Eggmansmile/DIY-Auto/Drawings/DIY-Auto_v4.pdf

## BOVENAANZICHT

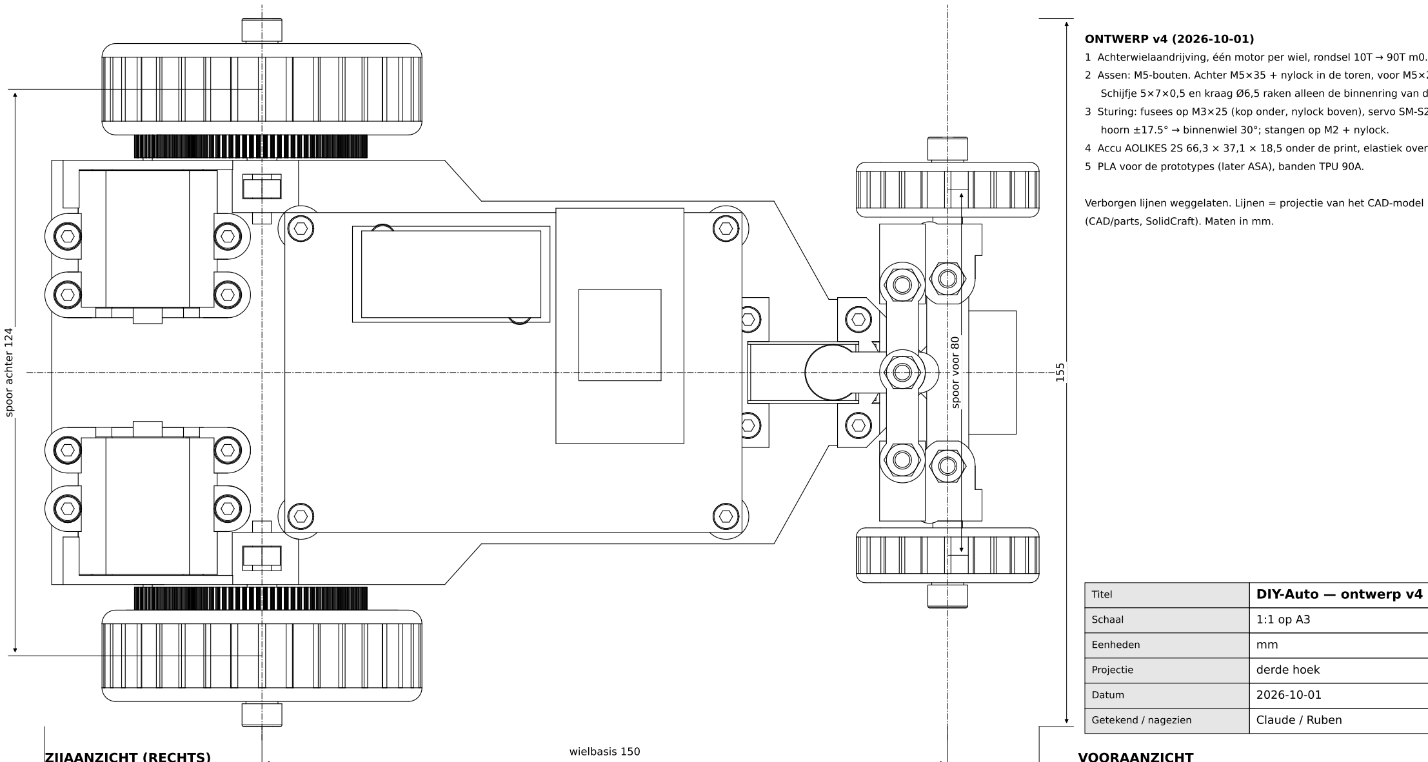
[picture p6: figure]
ONTWERP v4 (2026-10-01); (CAD/parts, SolidCraft). Maten in mm.; Titel; DIY-Auto — ontwerp v4; Schaal; Eenheden; Projectie; derde hoek; Datum; Getekend / nagezien; Claude / Ruben; wielbasis 150; spoor voor 80; spoor achter 124

ZIJAANZICHT (RECHTS) | VOORAANZICHT

1 Achterwielaandrijving, één motor per wiel, rondsel 10T → 90T m0.5 in de velg (9:1).

2 Assen: M5-bouten. Achter M5×35 + nylock in de toren, voor M5×20 + moer in de fusee.

Schijfje 5×7×0,5 en kraag Ø6,5 raken alleen de binnenring van de MR105.

3 Sturing: fusees op M3×25 (kop onder, nylock boven), servo SM-S2309S rechtop,
hoorn ±17.5° → binnenwiel 30°; stangen op M2 + nylock.

4 Accu AOLIKES 2S 66,3 × 37,1 × 18,5 onder de print, elastiek over 4 haakjes.

5 PLA voor de prototypes (later ASA), banden TPU 90A.

Verborgen lijnen weggelaten. Lijnen = projectie van het CAD-model

218

Ø70

Ø40

70

10

155
