Eggmansmile/DIY-Auto/Auto Design.excalidraw.md

---

excalidraw-plugin: parsed
tags: [excalidraw]

---
==⚠  Switch to EXCALIDRAW VIEW in the MORE OPTIONS menu of this document. ⚠== You can decompress Drawing data with the command palette: 'Decompress current Excalidraw file'. For more info check in plugin settings under 'Saving'

# Excalidraw Data

## Text Elements
differentieel aandrijving
met links of rechts die meer power krijgt
 ^oEhwQtGx

esp ^Jzh4QipB

esp ^W9gn68HW

wielen ^z8BO2pZM

holes for mounting
 ^FxBgVjIp

grote wielen vanachter
kleine wielen vanvoor zonder aandrijving ^ARltkxSG

rond binnenwiel ^oJuK1OJ4

car body ^HocfC2jY

treaded insert m2 ^xUrt5vSw

clamps like that so motor stays tight and cant go anywhere
while it just slots into the body and then gets clamped when
assembled with car body ^4d9SldyF

front wheels ^lo8yKOJZ

Concept v2 — Claude, 2026-09-26
• Rear wheel drive, 1 motor per wheel, 7:1 in one stage:
   pinion 10T m0.6 → 70T (Ø42) on the inside of the wheel, centre distance 24
• Front: steered by servo GWS Mini STD, C-hub knuckles on M3 kingpins, ±30°, servo upside down, TPU tyres
• Axles fixed (Ø5 steel), wheels on 2× MR105 each → 8 of the 10 bearings
• Motor in a cradle in the body, clamp on top with 2× M2 into inserts
• Battery 3×18650 in front of the rear axle, PCB above it on M3 standoffs
• PCB gets buck converter 12 V → 5 V + servo header; powerbank goes
• Car 212 × 144 × 61 mm, wheelbase 150, rear track 124 ^clV2txt1

## Embedded Files
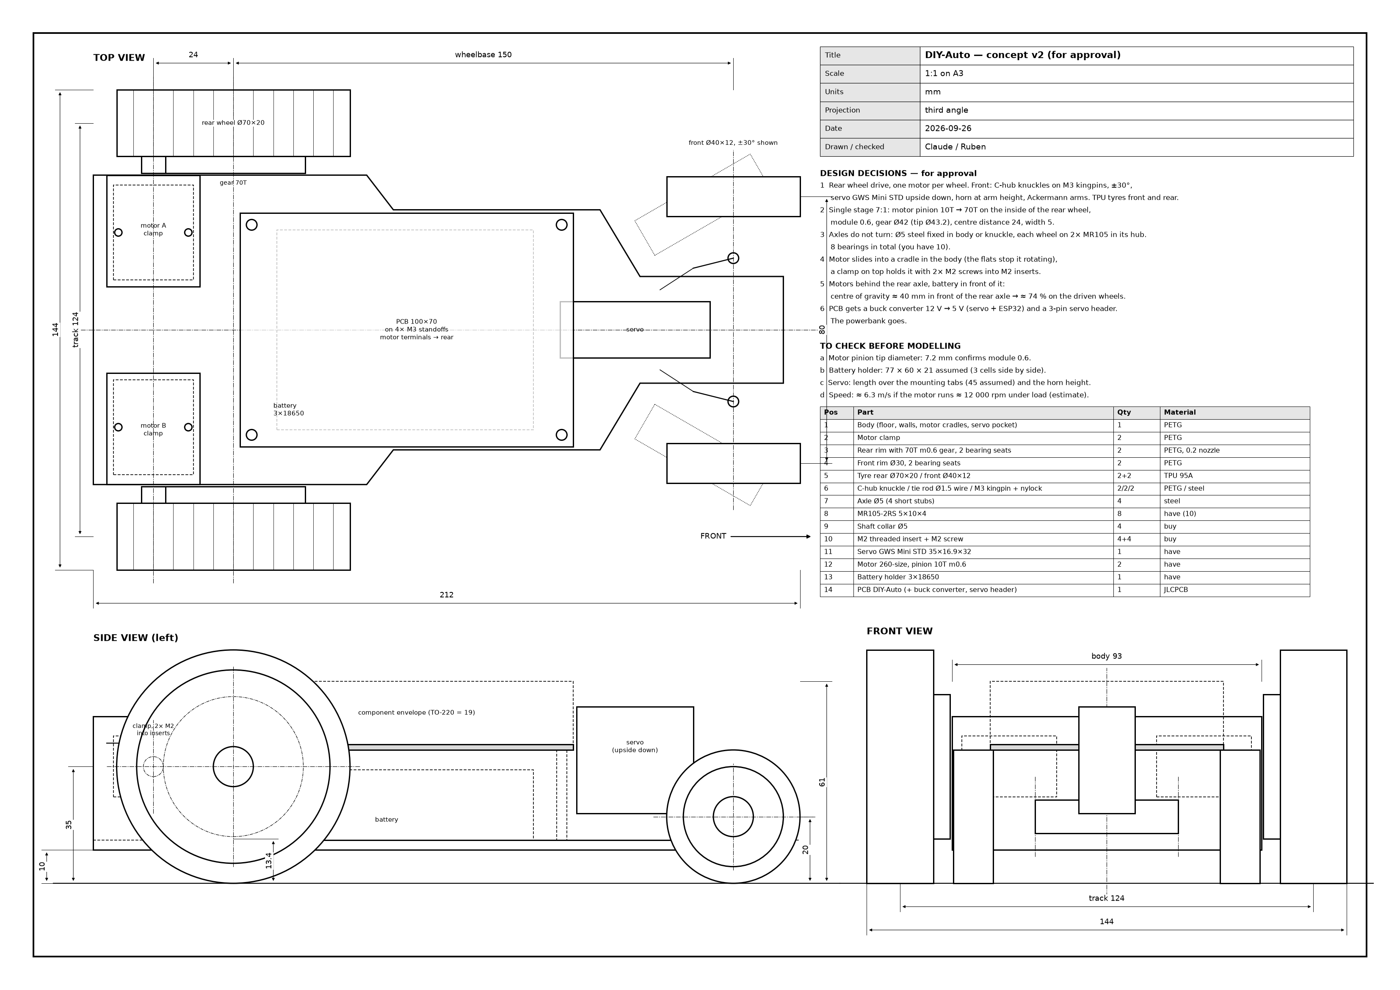
[picture p7: Drawings/DIY-Auto_concept_v2.png]
5c9b796a37b0570447a3e996b1d5a22d1349265a: 
d5ef25c8e838adc9a45d4e26cbdbbc654350cd61: 

d14e5dffaff56cf9605681765ca7cb864923935a: 

%%
## Drawing
```json
{
	"type": "excalidraw",
	"version": 2,
	"source": "https://github.com/zsviczian/obsidian-excalidraw-plugin/releases/tag/2.27.3",
	"elements": [
		{
			"id": "P3kD2CfJ9Grdw8lFDF6dV",
			"type": "freedraw",
			"x": -770.7141418457031,
			"y": -715.5225103339919,
			"width": 16.4273681640625,
			"height": 12.041351318359375,
			"angle": 0,
			"strokeColor": "#1e1e1e",
			"backgroundColor": "transparent",
			"fillStyle": "solid",
			"strokeWidth": 1,
			"strokeStyle": "solid",
			"roughness": 1,
			"opacity": 100,
			"groupIds": [],
			"frameId": null,
			"index": "a5",
			"roundness": null,
			"seed": 472087365,
			"version": 29,
			"versionNonce": 1761470539,
			"isDeleted": false,
			"boundElements": [],
			"updated": 1789668760306,
			"link": null,
			"locked": false,
			"points": [
				[
					0,
					0
				],
				[
					-1.095458984375,
					-1.091156005859375
				],
				[
					-1.095458984375,
					0
				],
				[
					0,
					0
				],
				[
					1.095458984375,
					1.095458984375
				],
				[
					2.19091796875,
					2.190887451171875
				],
				[
					4.38177490234375,
					2.190887451171875
				],
				[
					5.47296142578125,
					3.286346435546875
				],
				[
					7.663818359375,
					3.286346435546875
				],
				[
					8.75927734375,
					3.286346435546875
				],
				[
					9.854736328125,
					2.190887451171875
				],
				[
					12.04559326171875,
					1.095458984375
				],
				[
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
			"roundness": null,
			"seed": 637622757,
			"version": 8,
			"versionNonce": 427212645,
			"isDeleted": false,
			"boundElements": [],
			"updated": 1789668967552,
			"link": null,
			"locked": false,
			"points": [
				[
					0,
					0
				],
				[
					-1.095458984375,
					0
				],
				[
					-2.19085693359375,
					0
				],
				[
					-2.19085693359375,
					1.0911865234375
				],
				[
					-2.19085693359375,
					3.28204345703125
				],
				[
					0,
					10.94586181640625
				],
				[
					0,
					10.94586181640625
				]
			],
			"pressures": [],
			"simulatePressure": true,
			"strokeOptions": {
				"variability": "constant",
				"streamline": 0.5
			},
			"hasTextLink": false
		},
		{
			"id": "oEhwQtGx",
			"type": "text",
			"x": -1380,
			"y": -230,
			"width": 711.9362182617188,
			"height": 135,
			"angle": 0,
			"strokeColor": "#1e1e1e",
			"backgroundColor": "transparent",
			"fillStyle": "solid",
			"strokeWidth": 2,
			"strokeStyle": "solid",
			"roughness": 1,
			"opacity": 100,
			"groupIds": [],
			"frameId": null,
			"index": "b0E",
			"roundness": null,
			"seed": 1735013643,
			"version": 87,
			"versionNonce": 1088908837,
			"isDeleted": false,
			"boundElements": [],
			"updated": 1789669004848,
			"locked": false,
			"text": "differentieel aandrijving\nmet links of rechts die meer power krijgt\n",
			"rawText": "differentieel aandrijving\nmet links of rechts die meer power krijgt\n",
			"fontSize": 36,
			"fontFamily": 5,
			"textAlign": "left",
			"verticalAlign": "top",
			"containerId": null,
			"originalText": "differentieel aandrijving\nmet links of rechts die meer power krijgt\n",
			"autoResize": true,
			"lineHeight": 1.25,
			"labelPosition": null,
			"hasTextLink": false,
			"link": null
		},
		{
			"id": "sjoFZnIl",
			"type": "rectangle",
			"x": -1180,
			"y": 20,
			"width": 180,
			"height": 320,
			"angle": 0,
			"strokeColor": "#1e1e1e",
			"backgroundColor": "transparent",
			"fillStyle": "solid",
			"strokeWidth": 2,
			"strokeStyle": "solid",
			"roughness": 1,
			"opacity": 100,
			"groupIds": [],
			"frameId": null,
			"index": "b0F",
			"roundness": {
				"type": 3
			},
			"seed": 996403429,
			"version": 40,
			"versionNonce": 1199432805,
			"isDeleted": false,
			"boundElements": [],
			"updated": 1789669078185,
			"link": null,
			"locked": false,
			"hasTextLink": false
		},
		{
			"id": "r4TEpLCO5OowaeMb0jqL5",
			"type": "freedraw",
			"x": -1214.2710876464844,
			"y": 54.11332340624244,
			"width": 51.47308349609375,
			"height": 60.2109375,
			"angle": 0,
			"strokeColor": "#1e1e1e",
			"backgroundColor": "transparent",
			"fillStyle": "solid",
			"strokeWidth": 1,
			"strokeStyle": "solid",
			"roughness": 1,
			"opacity": 100,
			"groupIds": [],
			"frameId": null,
			"index": "b0K",
			"roundness": null,
			"seed": 1962203883,
			"version": 59,
			"versionNonce": 1403867941,
			"isDeleted": false,
			"boundElements": [],
			"updated": 1789669083445,
			"link": null,
			"locked": false,
			"points": [
				[
					0,
					0
				],
				[
					0,
					-1.095458984375
				],
				[
					-1.095458984375,
					-1.095458984375
				],
				[
					-1.095458984375,
					0
				],
				[
					-1.095458984375,
					1.09539794921875
				],
				[
					0,
					4.37750244140625
				],
				[
					1.095458984375,
					9.85467529296875
				],
				[
					3.28204345703125,
					16.423095703125
				],
				[
					4.37750244140625,
					24.0869140625
				],
				[
					5.47296142578125,
					32.8419189453125
				],
				[
					7.663818359375,
					40.50579833984375
				],
				[
					8.75927734375,
					47.07415771484375
				],
				[
					9.854736328125,
					51.4559326171875
				],
				[
					9.854736328125,
					54.73797607421875
				],
				[
					10.9501953125,
					55.83343505859375
				],
				[
					12.04559326171875,
					55.83343505859375
				],
				[
					13.14105224609375,
					54.73797607421875
				],
				[
					14.23651123046875,
					53.642578125
				],
				[
					16.42742919921875,
					51.4559326171875
				],
				[
					19.7137451171875,
					49.26507568359375
				],
				[
					22.99578857421875,
					47.07415771484375
				],
				[
					26.2821044921875,
					43.7921142578125
				],
				[
					29.5684814453125,
					41.6011962890625
				],
				[
					32.85479736328125,
					38.31915283203125
				],
				[
					40.51861572265625,
					33.9373779296875
				],
				[
					42.70953369140625,
					32.8419189453125
				],
				[
					45.995849609375,
					31.7464599609375
				],
				[
					47.09130859375,
					30.65533447265625
				],
				[
					48.186767578125,
					29.55987548828125
				],
				[
					48.186767578125,
					28.46441650390625
				],
				[
					47.09130859375,
					27.36895751953125
				],
				[
					45.995849609375,
					25.1781005859375
				],
				[
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
					-41.6011962890625
				],
				[
					-21.9046630859375,
					-47.07415771484375
				],
				[
					-26.28216552734375,
					-52.5513916015625
				],
				[
					-29.5684814453125,
					-59.1197509765625
				],
				[
					-32.85479736328125,
					-64.59271240234375
				],
				[
					-36.14117431640625,
					-70.065673828125
				],
				[
					-37.236572265625,
					-74.44744873046875
				],
				[
					-38.33203125,
					-77.7294921875
				],
				[
					-38.33203125,
					-81.015869140625
				],
				[
					-38.33203125,
					-83.20245361328125
				],
				[
					-38.33203125,
					-85.39337158203125
				],
				[
					-37.236572265625,
					-87.584228515625
				],
				[
					-36.14117431640625,
					-88.6796875
				],
				[
					-35.04571533203125,
					-89.775146484375
				],
				[
					-33.95025634765625,
					-90.86627197265625
				],
				[
					-31.7593994140625,
					-91.96173095703125
				],
				[
					-30.6639404296875,
					-93.05718994140625
				],
				[
					-28.4730224609375,
					-94.15264892578125
				],
				[
					-27.3775634765625,
					-95.248046875
				],
				[
					-26.28216552734375,
					-95.248046875
				],
				[
					-25.18670654296875,
					-95.248046875
				],
				[
					-24.09124755859375,
					-95.248046875
				],
				[
					-25.18670654296875,
					-94.15264892578125
				],
				[
					-25.18670654296875,
					-94.15264892578125
				]
			],
			"pressures": [],
			"simulatePressure": true,
			"strokeOptions": {
				"variability": "constant",
				"streamline": 0.5
			},
			"hasTextLink": false
		},
		{
			"id": "Jzh4QipB",
			"type": "text",
			"x": -1140,
			"y": 240,
			"width": 58.212005615234375,
			"height": 45,
			"angle": 0,
			"strokeColor": "#1e1e1e",
			"backgroundColor": "transparent",
			"fillStyle": "solid",
			"strokeWidth": 2,
			"strokeStyle": "solid",
			"roughness": 1,
			"opacity": 100,
			"groupIds": [],
			"frameId": null,
			"index": "b0O",
			"roundness": null,
			"seed": 1405081675,
			"version": 6,
			"versionNonce": 406341995,
			"isDeleted": false,
			"boundElements": [],
			"updated": 1789669093754,
			"locked": false,
			"text": "esp",
			"rawText": "esp",
			"fontSize": 36,
			"fontFamily": 5,
			"textAlign": "left",
			"verticalAlign": "top",
			"containerId": null,
			"originalText": "esp",
			"autoResize": true,
			"lineHeight": 1.25,
			"labelPosition": null,
			"hasTextLink": false,
			"link": null
		},
		{
			"id": "tE_Fy1mOpGGM63TZ11cpw",
			"type": "freedraw",
			"x": -1203.3209533691406,
			"y": 244.60526676561744,
			"width": 27.38189697265625,
			"height": 49.26507568359375,
			"angle": 0,
			"strokeColor": "#1e1e1e",
			"backgroundColor": "transparent",
			"fillStyle": "solid",
			"strokeWidth": 1,
			"strokeStyle": "solid",
			"roughness": 1,
			"opacity": 100,
			"groupIds": [],
			"frameId": null,
			"index": "b0P",
			"roundness": null,
			"seed": 2040952357,
			"version": 69,
			"versionNonce": 533024747,
			"isDeleted": false,
			"boundElements": [],
			"updated": 1789669096911,
			"link": null,
			"locked": false,
			"points": [
				[
					0,
					0
				],
				[
					-1.095458984375,
					1.095458984375
				],
				[
					-1.095458984375,
					2.19091796875
				],
				[
					-2.19091796875,
					3.286376953125
				],
				[
					-2.19091796875,
					5.47296142578125
				],
				[
					-2.19091796875,
					6.56842041015625
				],
				[
					-2.19091796875,
					8.75927734375
				],
				[
					-2.19091796875,
					10.9459228515625
				],
				[
					-1.095458984375,
					14.23223876953125
				],
				[
					-1.095458984375,
					17.5185546875
				],
				[
					0,
					19.7052001953125
				],
				[
					0,
					22.99151611328125
				],
				[
					1.09539794921875,
					26.2735595703125
				],
				[
					1.09539794921875,
					29.5599365234375
				],
				[
					1.09539794921875,
					32.84197998046875
				],
				[
					2.19085693359375,
					36.1282958984375
				],
				[
					2.19085693359375,
					39.4146728515625
				],
				[
					2.19085693359375,
					42.69671630859375
				],
				[
					2.19085693359375,
					44.8875732421875
				],
				[
					2.19085693359375,
					45.9830322265625
				],
				[
					2.19085693359375,
					47.07421875
				],
				[
					2.19085693359375,
					48.169677734375
				],
				[
					2.19085693359375,
					47.07421875
				],
				[
					3.28631591796875,
					47.07421875
				],
				[
					4.38177490234375,
					47.07421875
				],
				[
					6.5726318359375,
					45.9830322265625
				],
				[
					7.6680908203125,
					45.9830322265625
				],
				[
					9.8590087890625,
					44.8875732421875
				],
				[
					12.04986572265625,
					43.79217529296875
				],
				[
					13.14532470703125,
					43.79217529296875
				],
				[
					14.24078369140625,
					42.69671630859375
				],
				[
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
					1.095458984375
				],
				[
					0,
					4.38177490234375
				],
				[
					4.38177490234375,
					14.23223876953125
				],
				[
					4.38177490234375,
					14.23223876953125
				]
			],
			"pressures": [],
			"simulatePressure": true,
			"strokeOptions": {
				"variability": "constant",
				"streamline": 0.5
			},
			"hasTextLink": false
		},
		{
			"id": "PxluCl-lmm1Np0LmcTcAd",
			"type": "line",
			"x": -1280.0721958724876,
			"y": 720.7577578917146,
			"width": 360,
			"height": 0,
			"angle": 0,
			"strokeColor": "#1e1e1e",
			"backgroundColor": "transparent",
			"fillStyle": "solid",
			"strokeWidth": 2,
			"strokeStyle": "solid",
			"roughness": 1,
			"opacity": 100,
			"groupIds": [],
			"frameId": null,
			"index": "b0y",
			"roundness": {
				"type": 2
			},
			"seed": 1999169460,
			"version": 25,
			"versionNonce": 1989375284,
			"isDeleted": false,
			"boundElements": [],
			"updated": 1789758603783,
			"link": null,
			"locked": false,
			"points": [
				[
					0,
					0
				],
				[
					360,
					0
				]
			],
			"startBinding": null,
			"endBinding": null,
			"startArrowhead": null,
			"endArrowhead": null,
			"polygon": false,
			"hasTextLink": false
		},
		{
			"id": "R0OxuYmguQZseoDZxzi1R",
			"type": "freedraw",
			"x": -1359.53551459678,
			"y": 891.6903806110045,
			"width": 13.14105224609375,
			"height": 14.23223876953125,
			"angle": 0,
			"strokeColor": "#1e1e1e",
			"backgroundColor": "transparent",
			"fillStyle": "solid",
			"strokeWidth": 1,
			"strokeStyle": "solid",
			"roughness": 1,
			"opacity": 100,
			"groupIds": [],
			"frameId": null,
			"index": "b14",
			"roundness": null,
			"seed": 787001356,
			"version": 24,
			"versionNonce": 1522957836,
			"isDeleted": false,
			"boundElements": [],
			"updated": 1789759041253,
			"link": null,
			"locked": false,
			"points": [
				[
					0,
					0
				],
				[
					-1.0954437255859375,
					0
				],
				[
					-1.0954437255859375,
					-1.0911865234375
				],
				[
					0,
					-1.0911865234375
				],
				[
					0,
					-2.18658447265625
				],
				[
					1.0954437255859375,
					-3.28204345703125
				],
				[
					2.190887451171875,
					-4.37750244140625
				],
				[
					3.2863311767578125,
					-5.47296142578125
				],
				[
					5.4772186279296875,
					-6.56842041015625
				],
				[
					6.572662353515625,
					-7.663818359375
				],
				[
					8.763565063476562,
					-8.7550048828125
				],
				[
					9.854721069335938,
					-9.8504638671875
				],
				[
					10.950164794921875,
					-9.8504638671875
				],
				[
					12.045608520507812,
					-9.8504638671875
				],
				[
					12.045608520507812,
					-8.7550048828125
				],
				[
					12.045608520507812,
					-7.663818359375
				],
				[
					12.045608520507812,
					-6.56842041015625
				],
				[
					12.045608520507812,
					-4.37750244140625
				],
				[
					12.045608520507812,
					-2.18658447265625
				],
				[
					10.950164794921875,
					0
				],
				[
					10.950164794921875,
					1.095458984375
				],
				[
					10.950164794921875,
					4.38177490234375
				],
				[
					10.950164794921875,
					4.38177490234375
				]
			],
			"pressures": [],
			"simulatePressure": true,
			"strokeOptions": {
				"variability": "constant",
				"streamline": 0.5
			},
			"hasTextLink": false
		},
		{
			"id": "vciHR_vn9vJfwxLAjG4Dj",
			"type": "freedraw",
			"x": -1336.5354383028348,
			"y": 886.2174191852232,
			"width": 8.75927734375,
			"height": 9.8504638671875,
			"angle": 0,
			"strokeColor": "#1e1e1e",
			"backgroundColor": "transparent",
			"fillStyle": "solid",
			"strokeWidth": 1,
			"strokeStyle": "solid",
			"roughness": 1,
			"opacity": 100,
			"groupIds": [],
			"frameId": null,
			"index": "b15",
			"roundness": null,
			"seed": 653224716,
			"version": 18,
			"versionNonce": 1505418636,
			"isDeleted": false,
			"boundElements": [],
			"updated": 1789759041553,
			"link": null,
			"locked": false,
			"points": [
				[
					0,
					0
				],
				[
					1.095428466796875,
					-1.095458984375
				],
				[
					2.190887451171875,
					-1.095458984375
				],
				[
					3.28631591796875,
					-2.19085693359375
				],
				[
					4.38177490234375,
					-3.28204345703125
				],
				[
					5.477203369140625,
					-3.28204345703125
				],
				[
					6.568389892578125,
					-4.37750244140625
				],
				[
					7.663818359375,
					-3.28204345703125
				],
				[
					7.663818359375,
					-2.19085693359375
				],
				[
					7.663818359375,
					-1.095458984375
				],
				[
					7.663818359375,
					1.095458984375
				],
				[
					6.568389892578125,
					2.19091796875
				],
				[
					6.568389892578125,
					3.286376953125
				],
				[
					6.568389892578125,
					4.38177490234375
				],
				[
					6.568389892578125,
					5.47296142578125
				],
				[
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
					24.08697509765625
				],
				[
					-18.6182861328125,
					24.08697509765625
				],
				[
					-19.7137451171875,
					25.18243408203125
				],
				[
					-18.6182861328125,
					25.18243408203125
				],
				[
					-17.522857666015625,
					25.18243408203125
				],
				[
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
