Eggmansmile/DIY-Auto/CAD/solidcraft/snapshots/iso.png

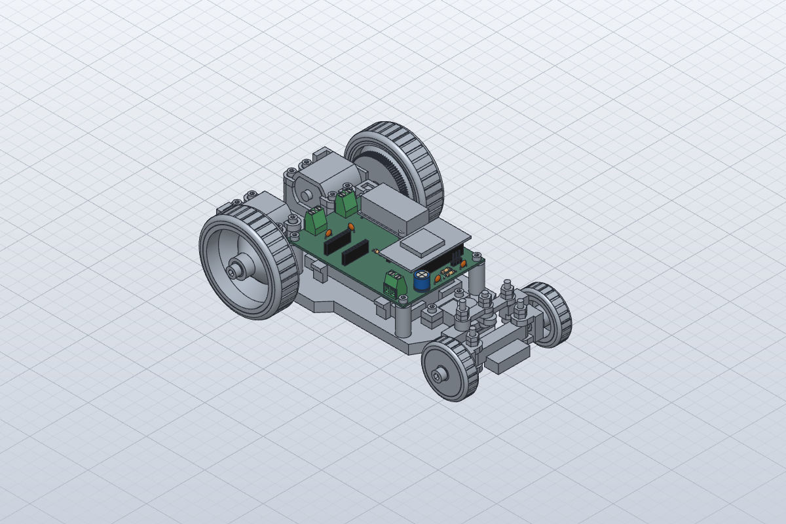
CAD/solidcraft/snapshots/iso.png
