Eggmansmile/DIY-Auto/CAD/solidcraft/snapshots/side.png

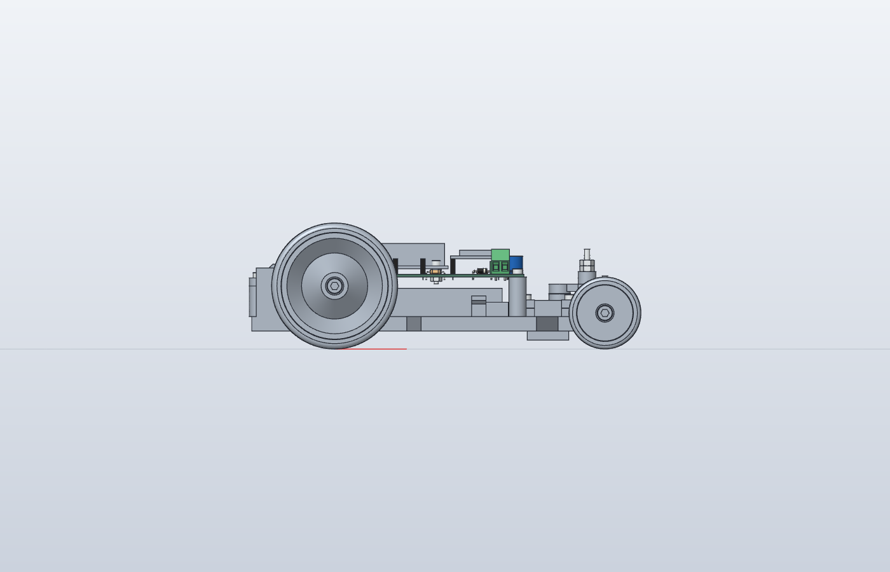
CAD/solidcraft/snapshots/side.png
