Eggmansmile/DIY-Auto/CAD/solidcraft/snapshots/top.png

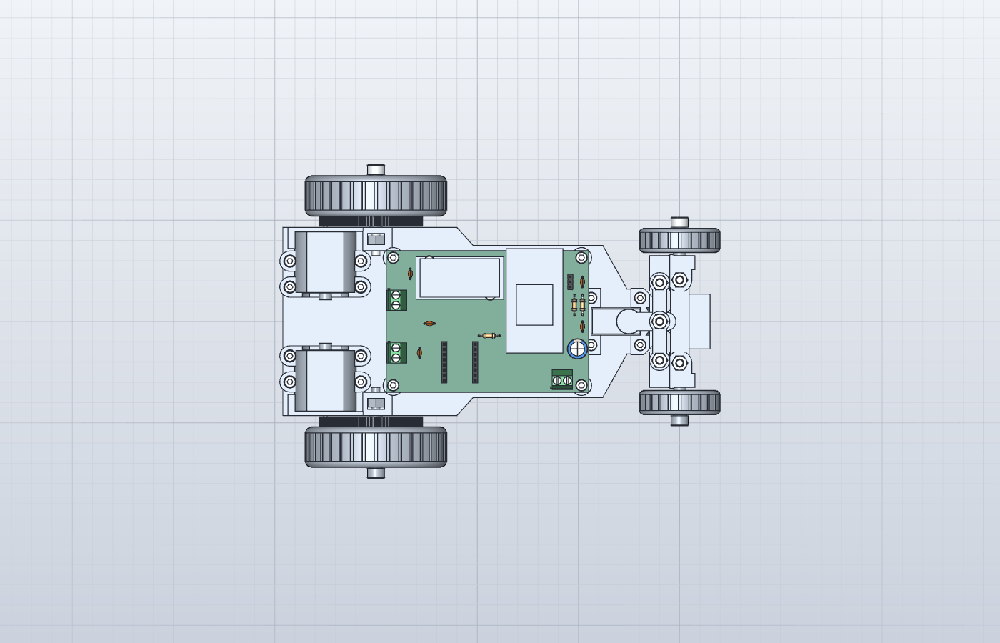
CAD/solidcraft/snapshots/top.png
