Eggmansmile/DIY-Auto/Drawings/DIY-Auto_v4.png

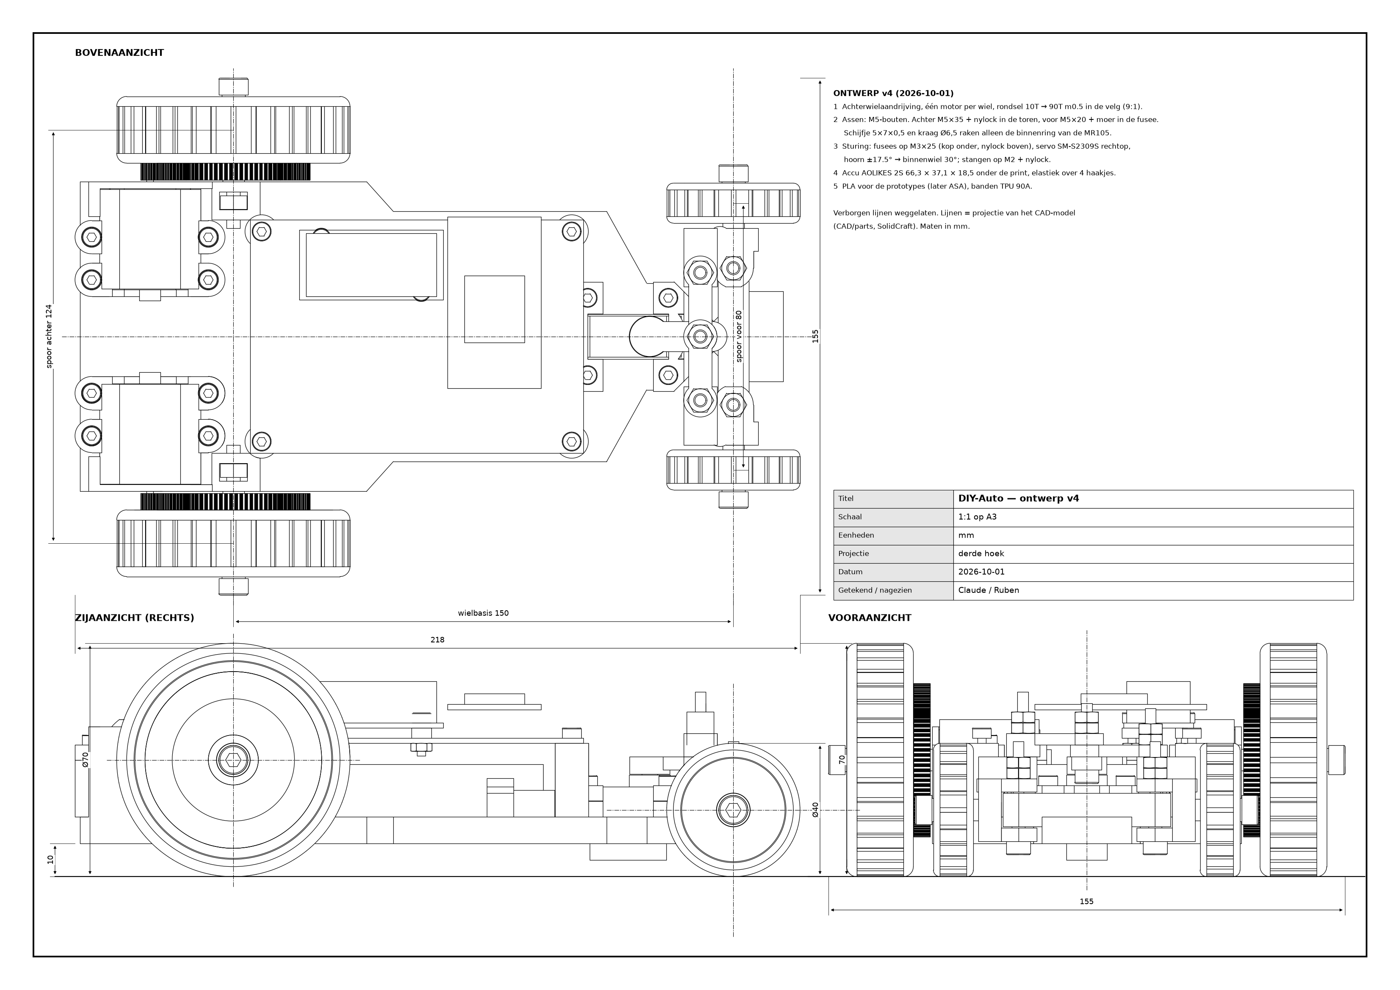
Drawings/DIY-Auto_v4.png
