Eggmansmile/DIY-Auto/CAD/parts/1 frame/body.step

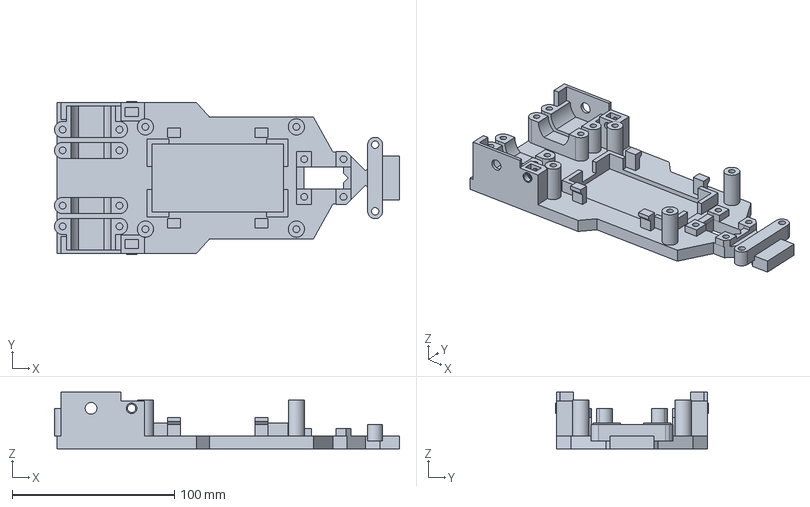
[picture p12: CAD file, 2026-11-12]
CAD/parts/1 frame/body.step
212.5 x 94.0 x 35.0 mm
