Eggmansmile/DIY-Auto/CAD/parts/2 rear drive/bearing_MR105_rear.step

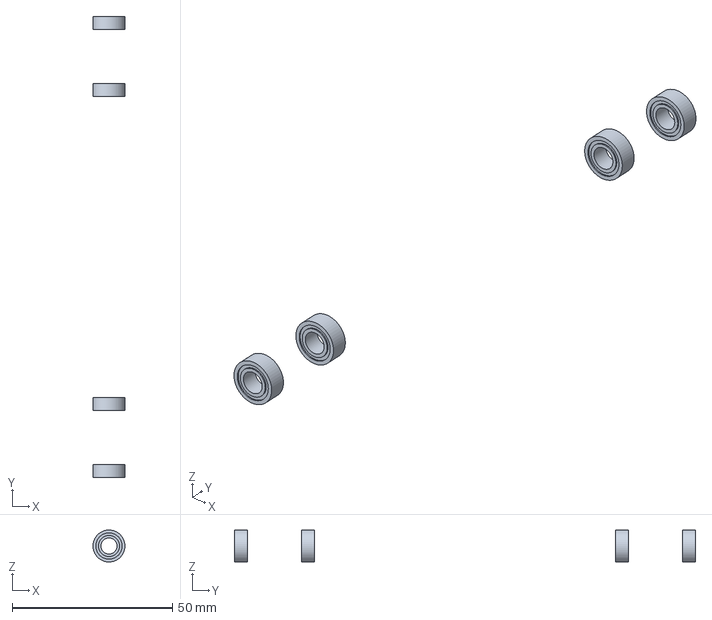
[picture p13: CAD file, 2026-11-10]
CAD/parts/2 rear drive/bearing_MR105_rear.step
9.99 x 144.0 x 10.00 mm
