Eggmansmile/DIY-Auto/CAD/parts/2 rear drive/print/rim_rear_R.step

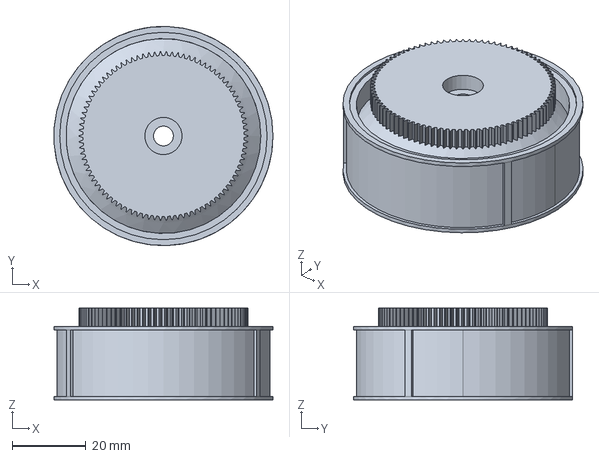
[picture p14: CAD file, 2026-11-12]
CAD/parts/2 rear drive/print/rim_rear_R.step
59.6 x 59.6 x 25.0 mm
