Eggmansmile/DIY-Auto/CAD/parts/3 front wheels/bearing_MR105_front.step

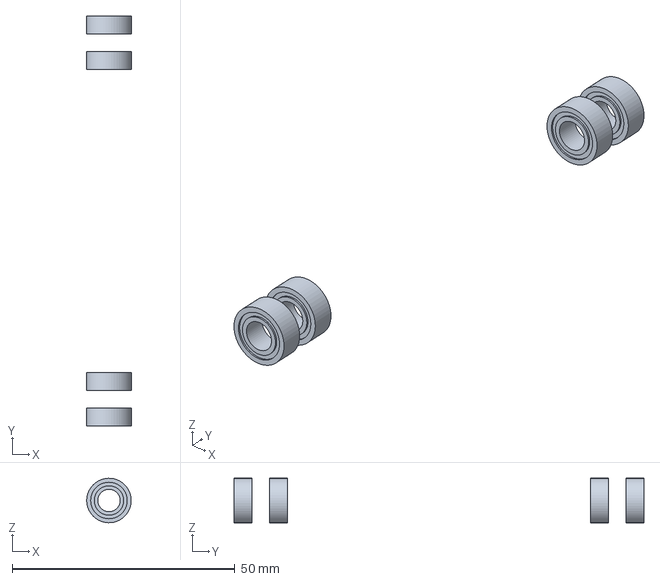
[picture p15: CAD file, 2026-11-10]
CAD/parts/3 front wheels/bearing_MR105_front.step
9.99 x 92.0 x 10.00 mm
