Eggmansmile/DIY-Auto/CAD/parts/3 front wheels/print/rim_front_L.step

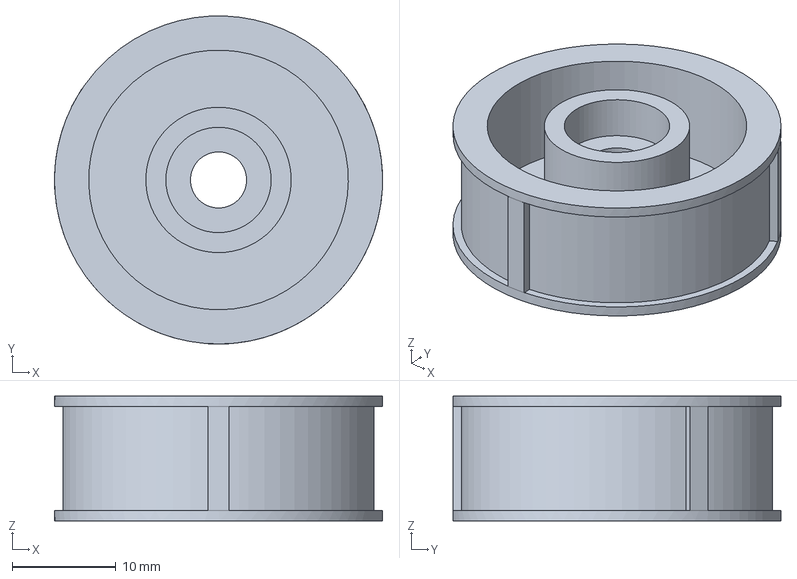
[picture p16: CAD file, 2026-11-12]
CAD/parts/3 front wheels/print/rim_front_L.step
31.6 x 31.6 x 12.0 mm
