Eggmansmile/DIY-Auto/CAD/parts/4 steering/knuckle_L.step

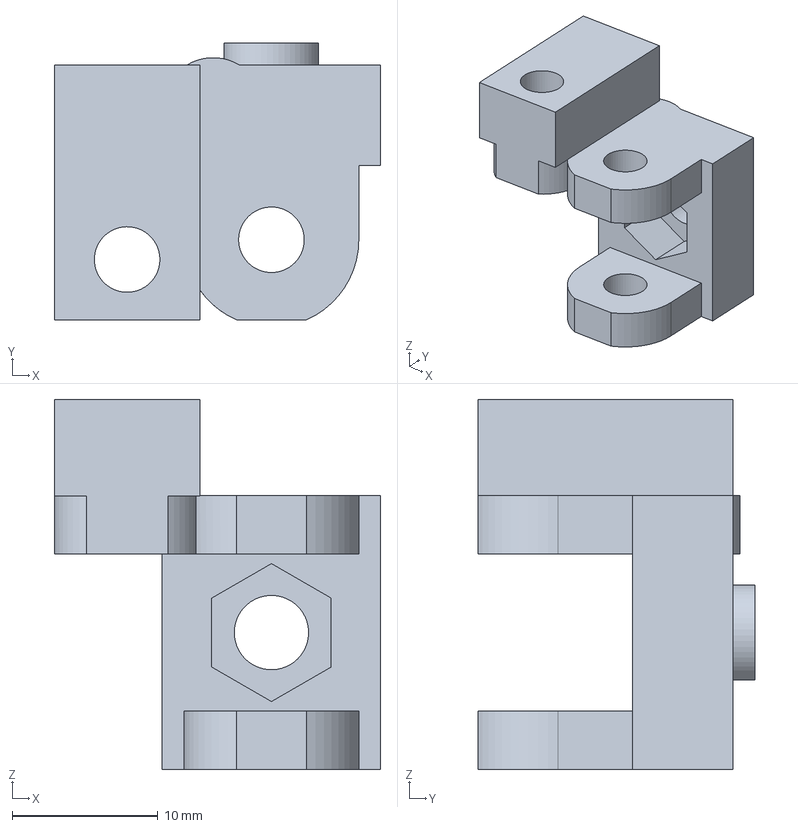
[picture p17: CAD file, 2026-11-12]
CAD/parts/4 steering/knuckle_L.step
22.4 x 19.0 x 25.4 mm
