Eggmansmile/DIY-Auto/CAD/parts/4 steering/print/tie_rod_R.step

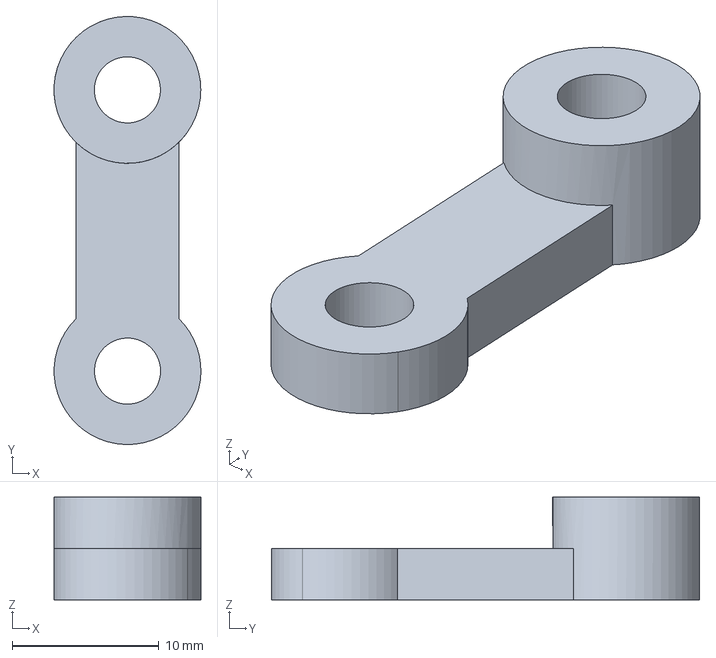
[picture p18: CAD file, 2026-11-12]
CAD/parts/4 steering/print/tie_rod_R.step
10.00 x 29.1 x 7.00 mm
