Eggmansmile/DIY-Auto/CAD/parts/5 electronics/battery_2S.step

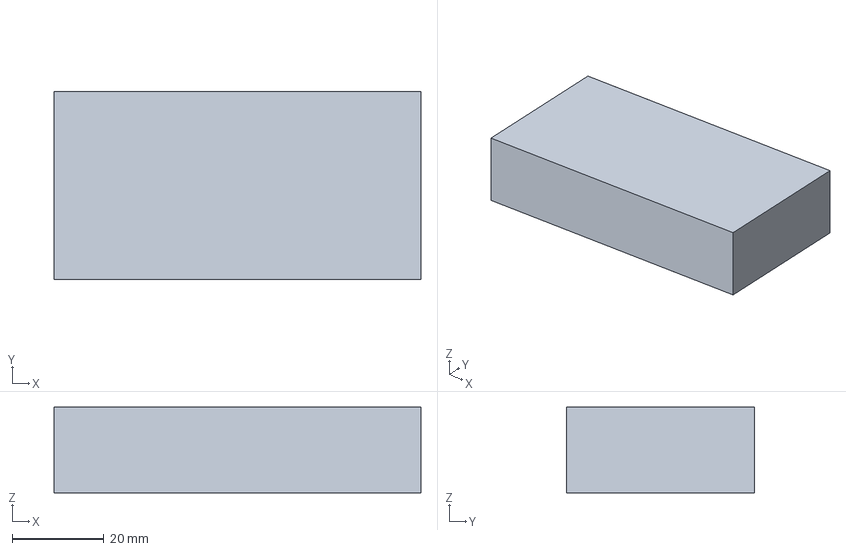
[picture p19: CAD file, 2026-11-10]
CAD/parts/5 electronics/battery_2S.step
80.0 x 41.0 x 18.7 mm
