Eggmansmile/DIY-Auto/CAD/parts/5 electronics/print/spacer_buck.step

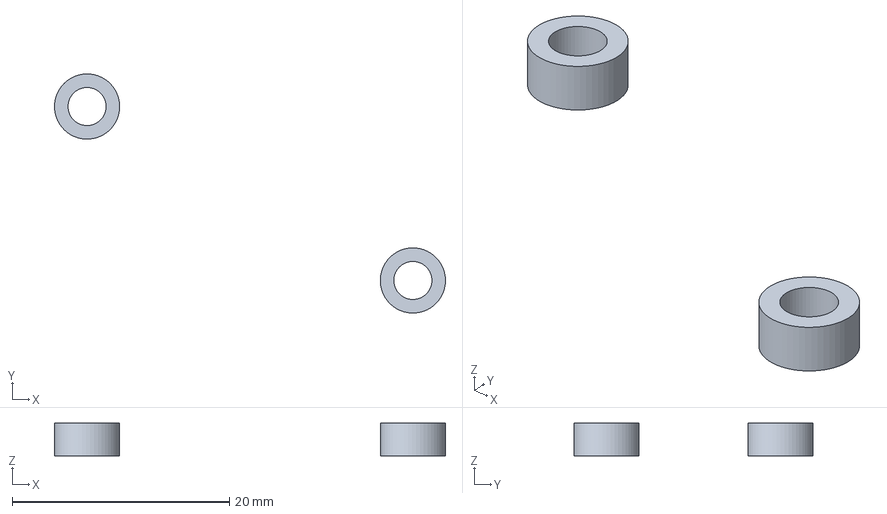
[picture p20: CAD file, 2026-11-12]
CAD/parts/5 electronics/print/spacer_buck.step
36.0 x 22.0 x 3.00 mm
