Eggmansmile/DIY-Auto/CAD/parts/test_fit/print/test_fit.stl

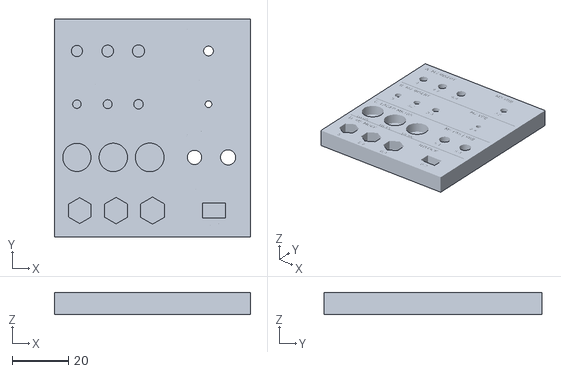
[picture p21: CAD file, 2026-11-07]
CAD/parts/test_fit/print/test_fit.stl
70.0 x 78.0 x 8.00
