Eggmansmile/DIY-Auto/CAD/plates/p1s-tpu/DIYAuto_banden_TPU95A.gcode.3mf

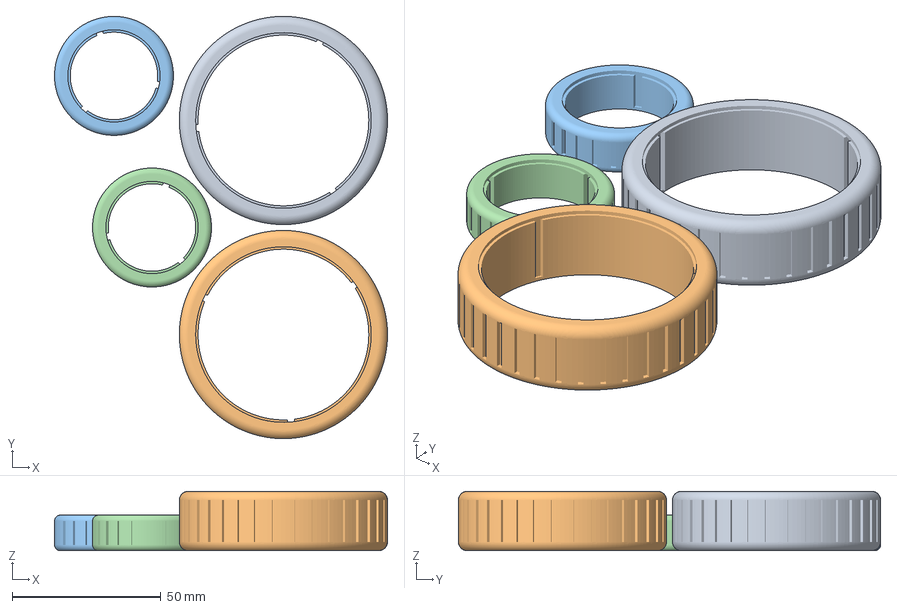
[picture p22: CAD file, 2026-11-07]
CAD/plates/p1s-tpu/DIYAuto_banden_TPU95A.gcode.3mf
112.0 x 142.0 x 20.0 mm
tyre_rear_R
tyre_rear_L
tyre_front_R
tyre_front_L
