Eggmansmile/DIY-Auto/CAD/plates/p1s/plaat2_PLA_0.2-nozzle.3mf

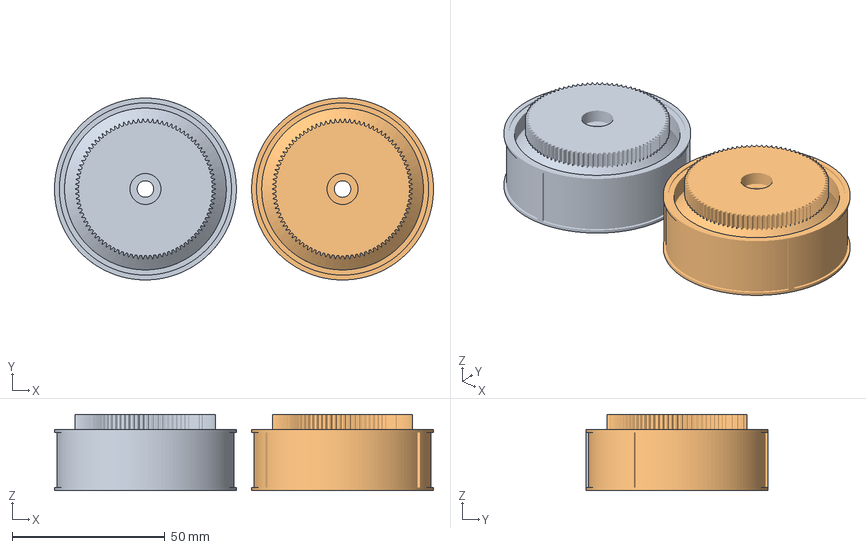
[picture p23: CAD file, 2026-11-12]
CAD/plates/p1s/plaat2_PLA_0.2-nozzle.3mf
124.2 x 59.6 x 25.0 mm
rim_rear_L
rim_rear_R
