Eggmansmile/DIY-Auto/CAD/ref/dc_motor.stl

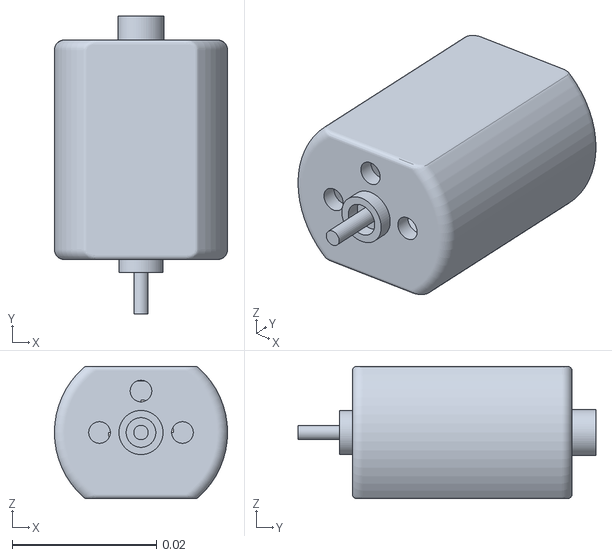
[picture p24: CAD file, 2026-11-07]
CAD/ref/dc_motor.stl
0.024 x 0.0413 x 0.0183
