Eggmansmile/DIY-Auto/KiCad/DIY-Auto.step

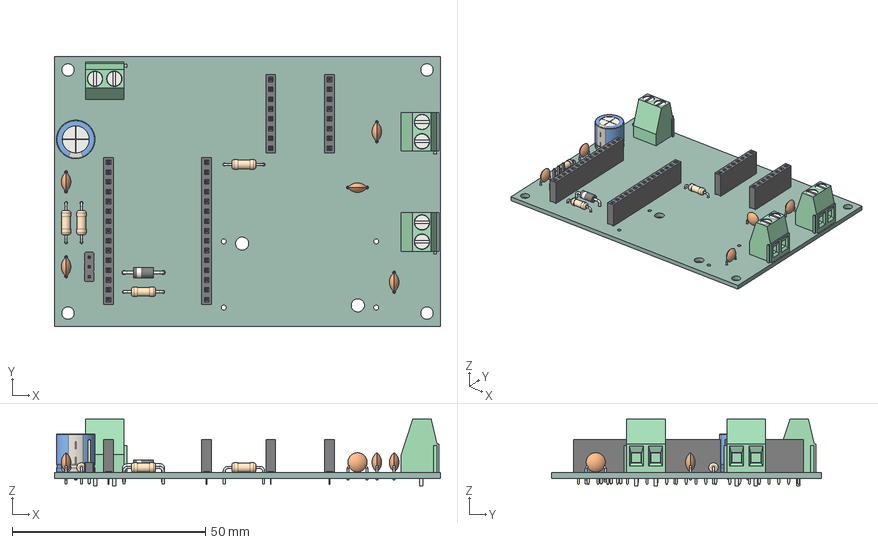
[picture p25: CAD file, 2026-11-07]
KiCad/DIY-Auto.step
100.0 x 70.0 x 17.3 mm
R_Axial_DIN0207_L63mm_D25mm_P1016mm_Horizontal x 4
PinSocket_1x08_P2.54mm_Vertical x 2
D_DO-41_SOD81_P10.16mm_Horizontal
TerminalBlock_Phoenix_MKDS-1,5-2_1x02_P5.00mm_Horizontal x 3
C_Disc_D50mm_W25mm_P500mm x 5
PinSocket_1x15_P2.54mm_Vertical x 2
CP_Radial_D100mm_P500mm
PinHeader_1x03_P254mm_Vertical
DIY-Auto_PCB
