Eggmansmile/DIY-Auto/Video/assets/motor_R.stl

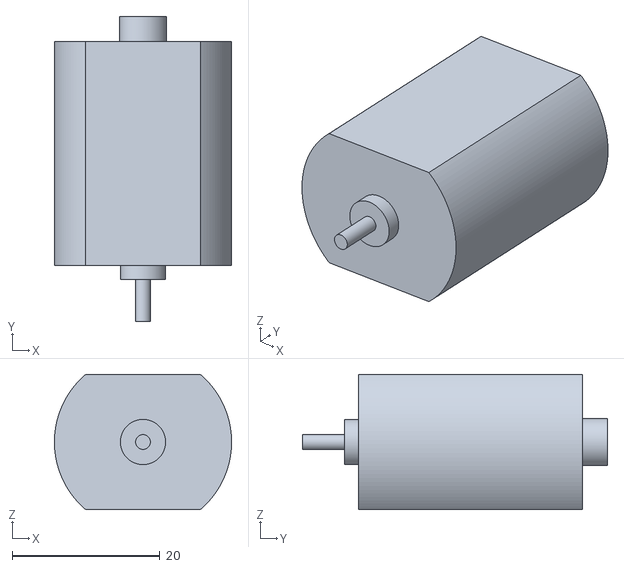
[picture p26: CAD file, 2026-11-07]
Video/assets/motor_R.stl
24.0 x 41.3 x 18.3
