Eggmansmile/DIY-Auto/CAD/parts/1 frame/clamp_L.step

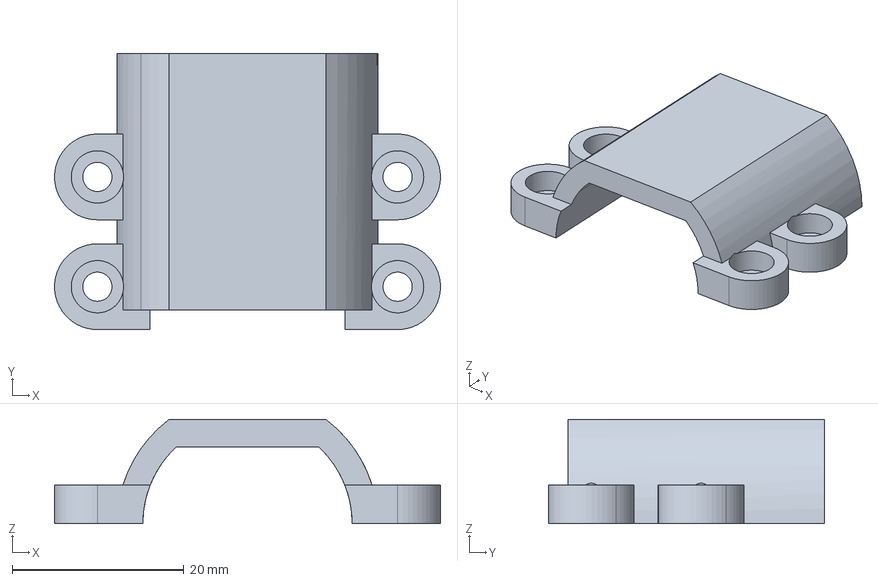
[picture p27: CAD file, 2026-11-12]
CAD/parts/1 frame/clamp_L.step
45.0 x 32.2 x 12.2 mm
