Eggmansmile/DIY-Auto/CAD/parts/3 front wheels/print/tyre_front_R.step

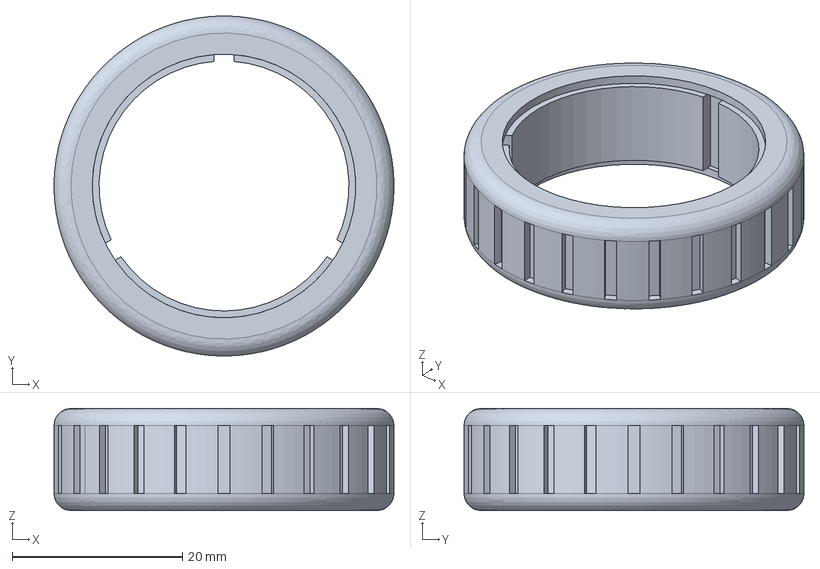
[picture p28: CAD file, 2026-11-12]
CAD/parts/3 front wheels/print/tyre_front_R.step
40.0 x 40.0 x 12.0 mm
