Eggmansmile/DIY-Auto/CAD/parts/4 steering/print/tie_rod_L.step

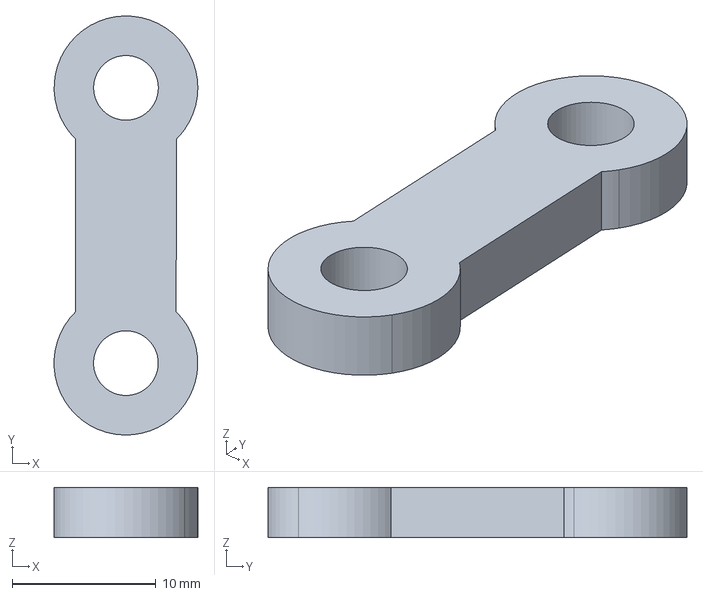
[picture p29: CAD file, 2026-11-12]
CAD/parts/4 steering/print/tie_rod_L.step
10.00 x 29.1 x 3.50 mm
