Eggmansmile/DIY-Auto/CAD/parts/5 electronics/devkit_ESP32.step

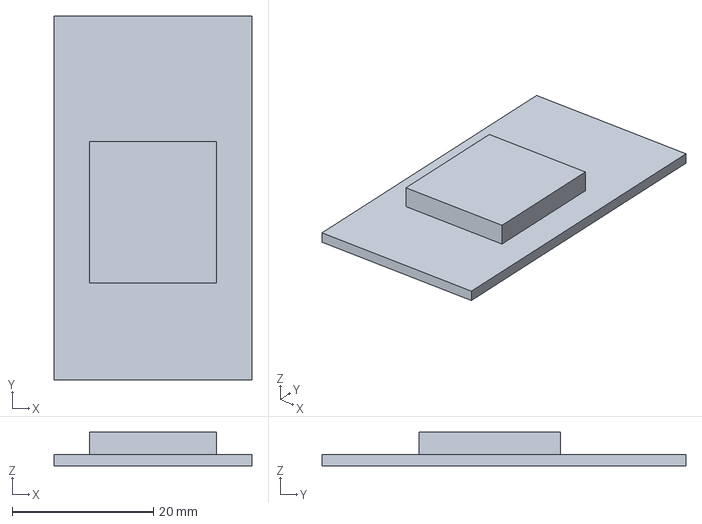
[picture p30: CAD file, 2026-11-10]
CAD/parts/5 electronics/devkit_ESP32.step
28.0 x 51.5 x 4.80 mm
