Eggmansmile/DIY-Auto/CAD/parts/2 rear drive/print/tyre_rear_R.step

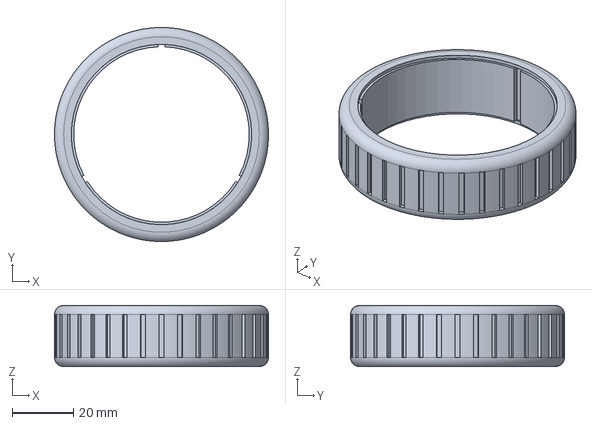
[picture p31: CAD file, 2026-11-12]
CAD/parts/2 rear drive/print/tyre_rear_R.step
70.0 x 70.0 x 20.0 mm
