Eggmansmile/DIY-Auto/CAD/parts/2 rear drive/shim_rear.step

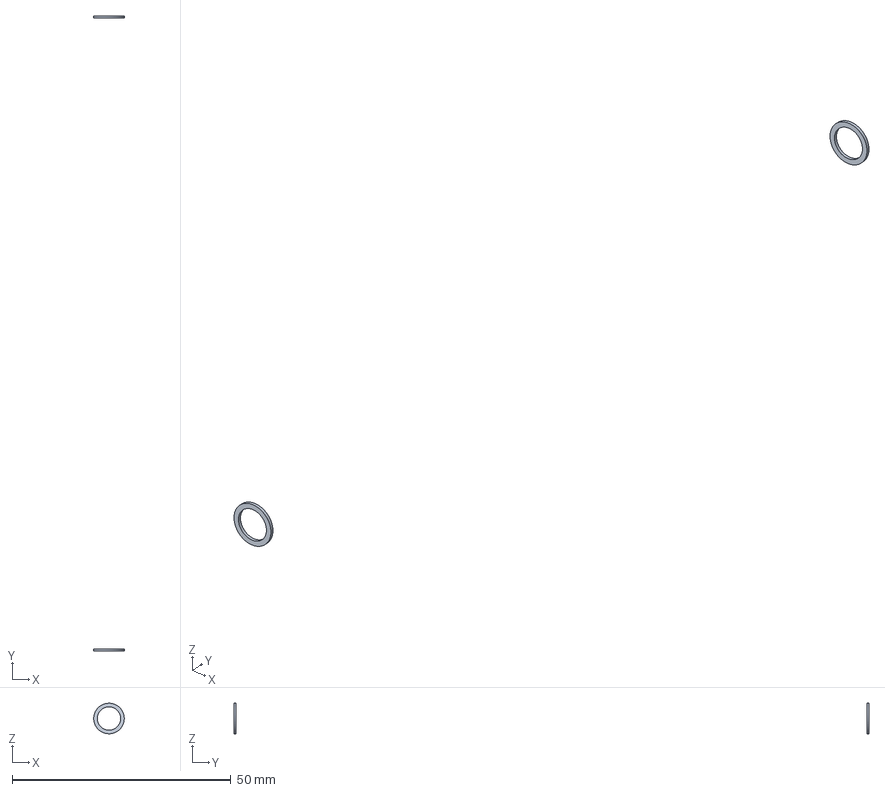
[picture p32: CAD file, 2026-11-10]
CAD/parts/2 rear drive/shim_rear.step
6.99 x 145.0 x 7.00 mm
