Eggmansmile/DIY-Auto/CAD/parts/4 steering/insert_M3x6_servo.step

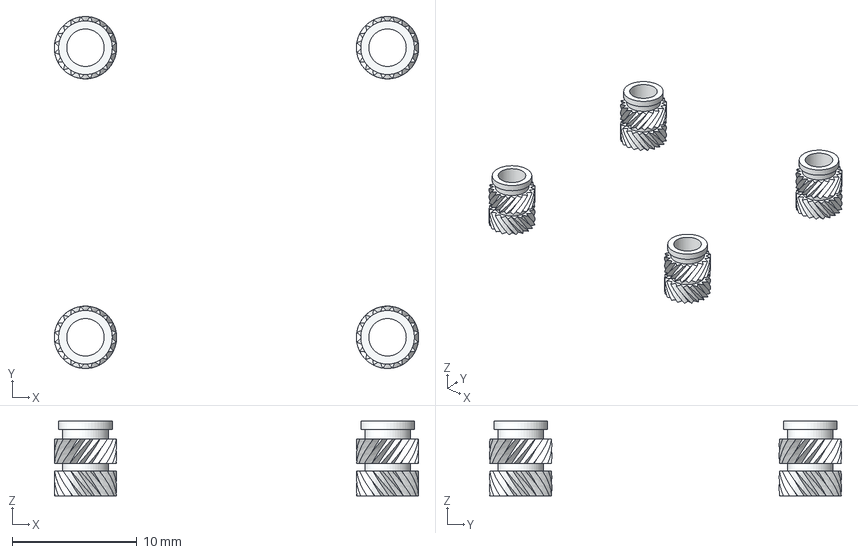
[picture p33: CAD file, 2026-11-10]
CAD/parts/4 steering/insert_M3x6_servo.step
29.2 x 28.2 x 6.00 mm
HeatSetNut(M3-0.5-6, Hilitchi) x 4
