Eggmansmile/DIY-Auto/CAD/parts/4 steering/print/servo_horn.step

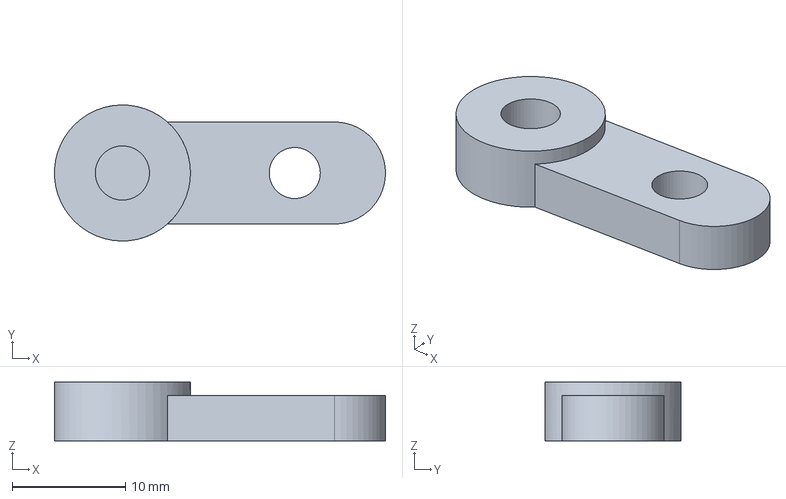
[picture p34: CAD file, 2026-11-12]
CAD/parts/4 steering/print/servo_horn.step
29.2 x 12.0 x 5.20 mm
