Eggmansmile/DIY-Auto/CAD/parts/5 electronics/buck_LM2596.step

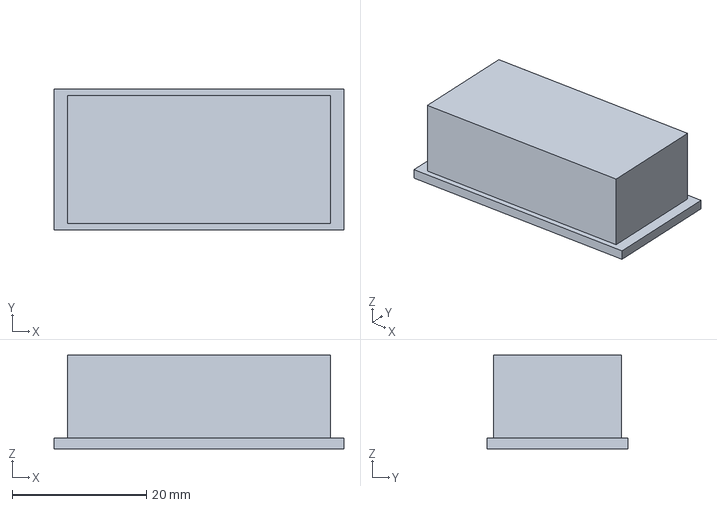
[picture p35: CAD file, 2026-11-10]
CAD/parts/5 electronics/buck_LM2596.step
43.2 x 21.0 x 14.0 mm
