Eggmansmile/DIY-Auto/CAD/plates/p1s-tpu/plaat3_TPU.3mf

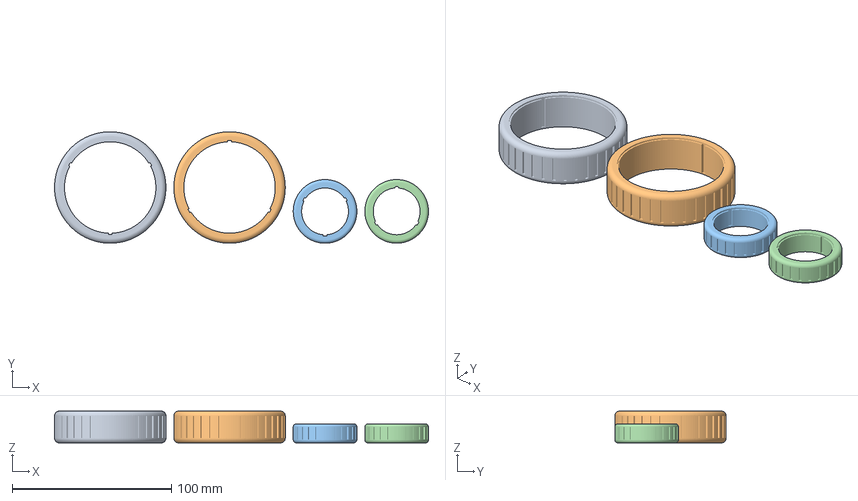
[picture p36: CAD file, 2026-11-07]
CAD/plates/p1s-tpu/plaat3_TPU.3mf
235.0 x 70.0 x 20.0 mm
tyre_rear_L
tyre_rear_R
tyre_front_L
tyre_front_R
