Eggmansmile/DIY-Auto/CAD/plates/p1s/plaat1_PLA_0.4.3mf

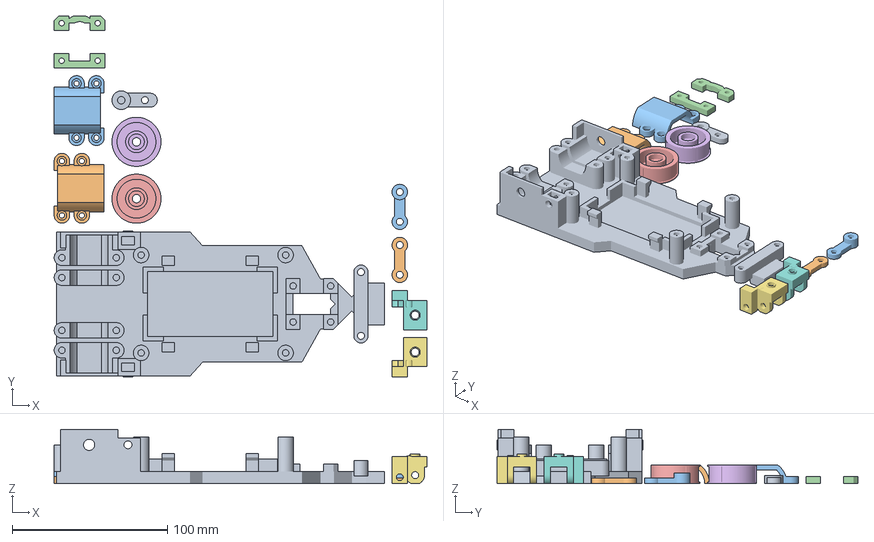
[picture p37: CAD file, 2026-11-12]
CAD/plates/p1s/plaat1_PLA_0.4.3mf
239.9 x 232.4 x 35.0 mm
clamp_R
clamp_L
servo_clamp
rim_front_L
rim_front_R
knuckle_L
knuckle_R
servo_horn
tie_rod_L
tie_rod_R
