Eggmansmile/DIY-Auto/CAD/parts/1 frame/insert_M3x6_pcb.step

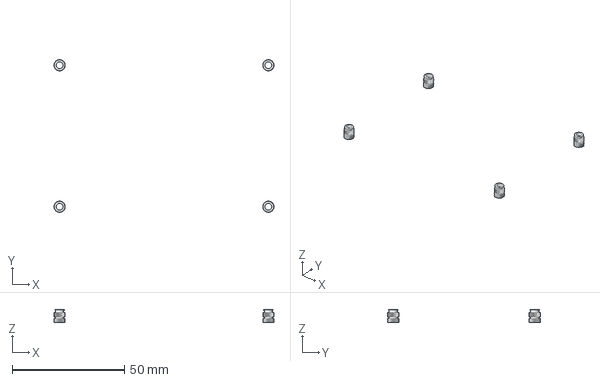
[picture p38: CAD file, 2026-11-10]
CAD/parts/1 frame/insert_M3x6_pcb.step
98.0 x 68.0 x 6.00 mm
HeatSetNut(M3-0.5-6, Hilitchi) x 4
