Eggmansmile/DIY-Auto/CAD/parts/4 steering/print/servo_clamp.step

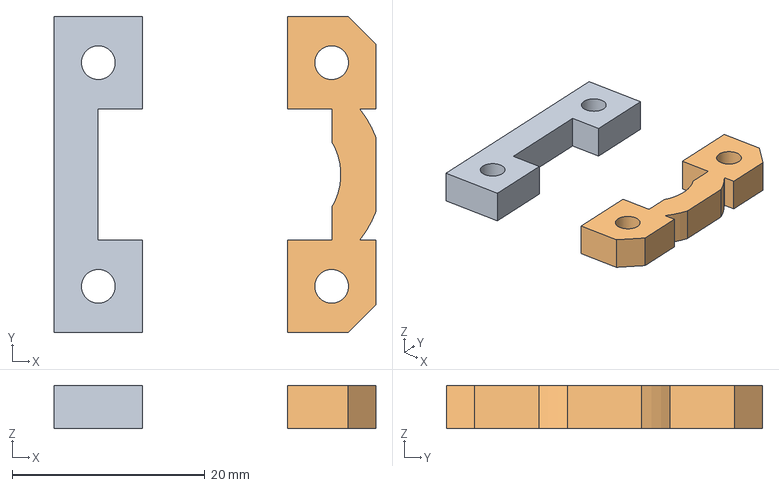
[picture p39: CAD file, 2026-11-12]
CAD/parts/4 steering/print/servo_clamp.step
33.4 x 32.8 x 4.50 mm
