Eggmansmile/DIY-Auto/CAD/parts/4 steering/shim_front.step

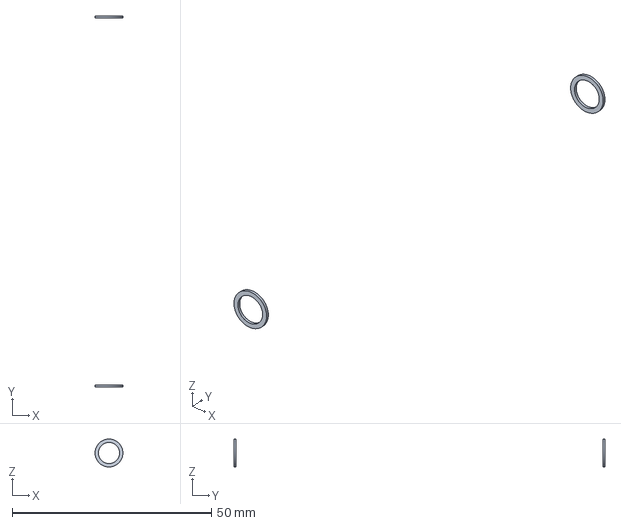
[picture p40: CAD file, 2026-11-10]
CAD/parts/4 steering/shim_front.step
6.99 x 93.0 x 7.00 mm
