Eggmansmile/DIY-Auto/CAD/parts/2 rear drive/pinion.step

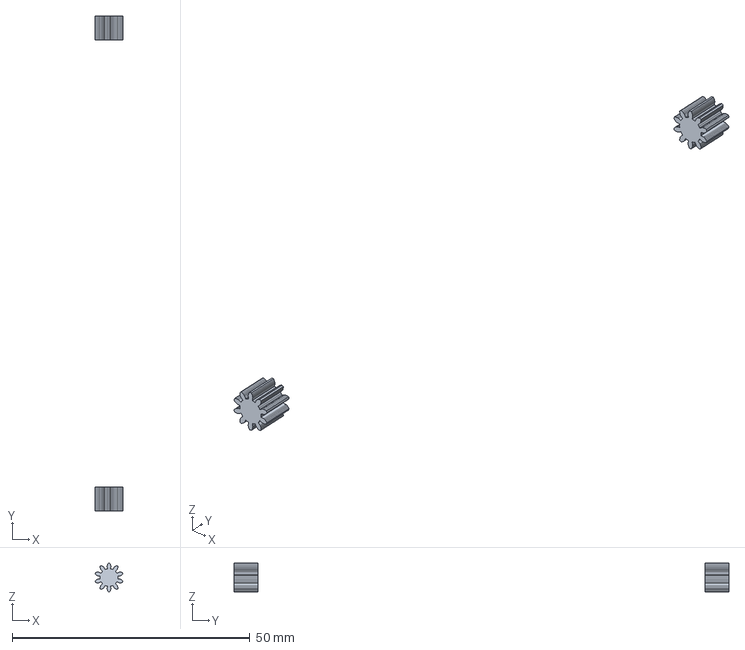
[picture p41: CAD file, 2026-11-10]
CAD/parts/2 rear drive/pinion.step
5.79 x 104.0 x 5.99 mm
