Eggmansmile/DIY-Auto/CAD/parts/4 steering/kingpin_M4x30.step

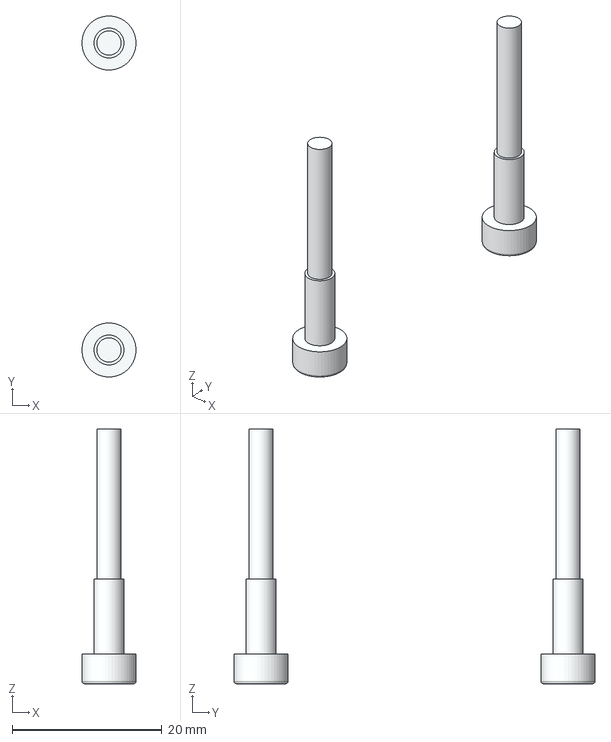
[picture p42: CAD file, 2026-11-10]
CAD/parts/4 steering/kingpin_M4x30.step
7.21 x 48.2 x 34.0 mm
SocketHeadCapScrew(M4-0.7, 30.00, iso4762) x 2
