Eggmansmile/DIY-Auto/CAD/parts/1 frame/insert_M3x6_strap.step

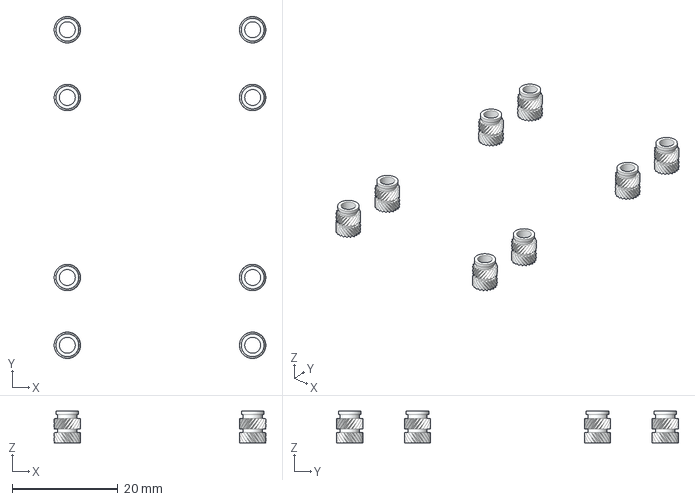
[picture p43: CAD file, 2026-11-10]
CAD/parts/1 frame/insert_M3x6_strap.step
40.0 x 64.6 x 6.00 mm
HeatSetNut(M3-0.5-6, Hilitchi) x 8
