Eggmansmile/DIY-Auto/CAD/parts/5 electronics/pcb_envelope.step

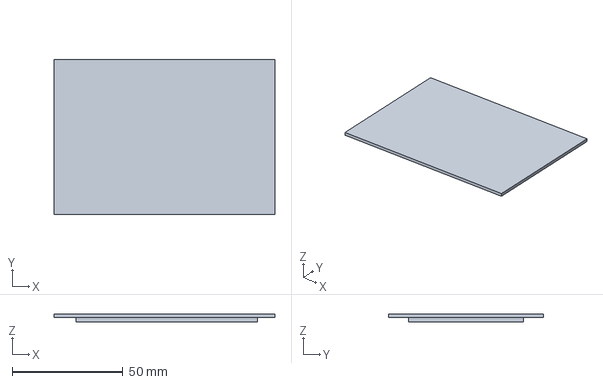
[picture p44: CAD file, 2026-11-10]
CAD/parts/5 electronics/pcb_envelope.step
100.0 x 70.0 x 3.60 mm
