Eggmansmile/DIY-Auto/CAD/parts/4 steering/servo.step

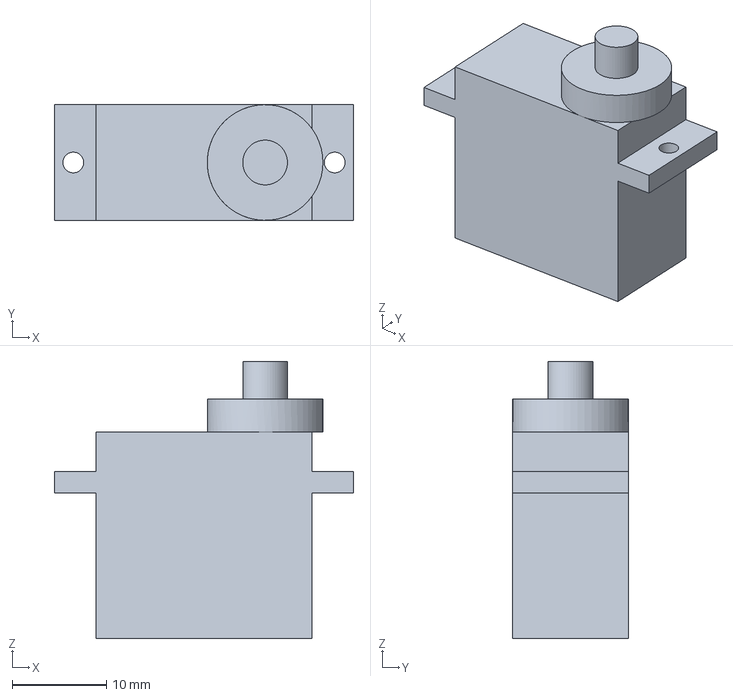
[picture p45: CAD file, 2026-11-10]
CAD/parts/4 steering/servo.step
31.8 x 12.3 x 29.5 mm
