Eggmansmile/DIY-Auto/(list of files, cad)

Other CAD files:
CAD/plates/h2d-v9/DIYAuto_v9_ASA_H2D.3mf
CAD/parts/2 rear drive/print/rim_rear_L.step
CAD/parts/4 steering/knuckle_R.step
CAD/plates/p1s-tpu/DIYAuto_banden_TPU95A_P1S.3mf
CAD/plates/p1s/plaat0_PLA_testblok.3mf
Video/assets/motor_L.stl
CAD/parts/1 frame/clamp_R.step
CAD/parts/3 front wheels/print/rim_front_R.step
CAD/parts/2 rear drive/print/tyre_rear_L.step
CAD/parts/3 front wheels/print/tyre_front_L.step
CAD/parts/1 frame/motor_R.step
CAD/parts/1 frame/motor_L.step
CAD/parts/1 frame/body.stl
CAD/parts/1 frame/clamp_L.stl
CAD/parts/1 frame/clamp_R.stl
CAD/parts/1 frame/insert_M3x6_pcb.stl
CAD/parts/1 frame/insert_M3x6_strap.stl
CAD/parts/1 frame/print/body.step
CAD/parts/1 frame/print/body.stl
CAD/parts/1 frame/print/clamp_L.step
CAD/parts/1 frame/print/clamp_L.stl
CAD/parts/1 frame/print/clamp_R.step
CAD/parts/1 frame/print/clamp_R.stl
CAD/parts/1 frame/screw_M3x10_strap.step
CAD/parts/1 frame/screw_M3x10_strap.stl
CAD/parts/2 rear drive/axle_bolt_M5x40.step
CAD/parts/2 rear drive/axle_bolt_M5x40.stl
CAD/parts/2 rear drive/bearing_MR105_rear.stl
CAD/parts/2 rear drive/nut_M5_rear.step
CAD/parts/2 rear drive/nut_M5_rear.stl
CAD/parts/2 rear drive/pinion.stl
CAD/parts/2 rear drive/print/rim_rear_L.stl
CAD/parts/2 rear drive/print/rim_rear_R.stl
CAD/parts/2 rear drive/print/tyre_rear_L.stl
CAD/parts/2 rear drive/print/tyre_rear_R.stl
CAD/parts/2 rear drive/rim_rear_L.step
CAD/parts/2 rear drive/rim_rear_L.stl
CAD/parts/2 rear drive/rim_rear_R.step
CAD/parts/2 rear drive/rim_rear_R.stl
CAD/parts/2 rear drive/shim_rear.stl
CAD/parts/2 rear drive/tyre_rear_L.step
CAD/parts/2 rear drive/tyre_rear_L.stl
CAD/parts/2 rear drive/tyre_rear_R.step
CAD/parts/2 rear drive/tyre_rear_R.stl
CAD/parts/3 front wheels/bearing_MR105_front.stl
CAD/parts/3 front wheels/print/rim_front_L.stl
CAD/parts/3 front wheels/print/rim_front_R.stl
CAD/parts/3 front wheels/print/tyre_front_L.stl
CAD/parts/3 front wheels/print/tyre_front_R.stl
CAD/parts/3 front wheels/rim_front_L.step
CAD/parts/3 front wheels/rim_front_L.stl
CAD/parts/3 front wheels/rim_front_R.step
CAD/parts/3 front wheels/rim_front_R.stl
CAD/parts/3 front wheels/tyre_front_L.step
CAD/parts/3 front wheels/tyre_front_L.stl
CAD/parts/3 front wheels/tyre_front_R.step
CAD/parts/3 front wheels/tyre_front_R.stl
CAD/parts/4 steering/axle_bolt_M5x20.step
CAD/parts/4 steering/axle_bolt_M5x20.stl
CAD/parts/4 steering/insert_M3x6_servo.stl
CAD/parts/4 steering/kingpin_M4x30.stl
CAD/parts/4 steering/knuckle_L.stl
CAD/parts/4 steering/knuckle_R.stl
CAD/parts/4 steering/nut_M4_kingpin.step
CAD/parts/4 steering/nut_M4_kingpin.stl
CAD/parts/4 steering/nut_M4_steering.step
CAD/parts/4 steering/nut_M4_steering.stl
CAD/parts/4 steering/nut_M5_front.step
CAD/parts/4 steering/nut_M5_front.stl
CAD/parts/4 steering/print/knuckle_L.step
CAD/parts/4 steering/print/knuckle_L.stl
CAD/parts/4 steering/print/knuckle_R.step
CAD/parts/4 steering/print/knuckle_R.stl
CAD/parts/4 steering/print/servo_clamp.stl
CAD/parts/4 steering/print/servo_horn.stl
CAD/parts/4 steering/print/tie_rod_L.stl
CAD/parts/4 steering/print/tie_rod_R.stl
CAD/parts/4 steering/screw_M3x10_servo.step
CAD/parts/4 steering/screw_M3x10_servo.stl
CAD/parts/4 steering/screw_M4_steering.step
CAD/parts/4 steering/screw_M4_steering.stl
CAD/parts/4 steering/servo.stl
CAD/parts/4 steering/servo_clamp.step
CAD/parts/4 steering/servo_clamp.stl
CAD/parts/4 steering/servo_horn.step
CAD/parts/4 steering/servo_horn.stl
CAD/parts/4 steering/shim_front.stl
CAD/parts/4 steering/tie_rod_L.step
CAD/parts/4 steering/tie_rod_L.stl
CAD/parts/4 steering/tie_rod_R.step
CAD/parts/4 steering/tie_rod_R.stl
CAD/parts/5 electronics/battery_2S.stl
CAD/parts/5 electronics/buck_LM2596.stl
CAD/parts/5 electronics/devkit_ESP32.stl
CAD/parts/5 electronics/nut_M3_buck.step
CAD/parts/5 electronics/nut_M3_buck.stl
CAD/parts/5 electronics/pcb_envelope.stl
CAD/parts/5 electronics/print/spacer_buck.stl
CAD/parts/5 electronics/screw_M3x10_buck.step
CAD/parts/5 electronics/screw_M3x10_buck.stl
CAD/parts/5 electronics/screw_M3x6_pcb.step
CAD/parts/5 electronics/screw_M3x6_pcb.stl
CAD/parts/5 electronics/spacer_buck.step
CAD/parts/5 electronics/spacer_buck.stl
