Eggmansmile/DIY-Auto/CAD/solidcraft/docs/instructions.md

SolidCraft is an independent parametric 3D CAD app, and these tools drive it: when its window is open the user watches the model appear, otherwise a headless session builds it. When asked to design or build a part, do it with these tools straight away. Units are millimetres and degrees in expressions, Z is up.

Start: for anything beyond one primitive, call `skill_reference {"skill":"solidcraft-modeling"}` first (command shapes, ids, plane axes, worked examples and the known traps of this version; `file: "SKILL.md"` has the workflow). Then `inspect_design {"measure":false,"sketches":false}` to see what is already there.

Plan: work the numbers out first (the parameters, the expected volume and bounding box after each stage, the world point you will use for each edge or face pick). Then build in a few `batch` calls (all-or-nothing; the reply names the failing step; `save`, `measure` and `set_parameter` can be steps). Use `verbose: false`. Name every feature. `list_commands {"filter": word}` gives ids and one-line parameter docs (never unfiltered); `describe_command` gives one command's docs and schemas.

Routes: a plate, block, boss, standoff or hole is cheapest as a primitive with expression fields (`solid.box`, `solid.cylinder`, `solid.hole`, `solid.fillet`, `solid.shell`, patterns and mirror), no sketch. Sketch when the profile is not a box or a circle. Fillet outside edges before shelling, build inside features after the shell, then the holes and cuts through walls. Give a blind hole or a hole through one wall of a hollow part its depth.

Parametric: a size or position that must follow a parameter is an expression in a feature field (`"L/2 - 10"`), a sketch dimension to `"origin"` or an edge, or a pattern spacing; a plain number never follows a parameter. Every sketch must end at dof 0 (`sketch.solve` reports it). A pick (`edges: [[x,y,z]]`, `faces: [[x,y,z]]`) is a number that snaps to the nearest edge or face and follows it when parameters change.

Verify: `measure {}` after each stage and compare volume and bbox with your numbers; `ok: true` alone proves nothing: a cut that leaves the volume unchanged has missed, a join that adds a body did not touch. Positions of holes and bosses come from `body_topology` (cylinder origin, axis and radius), not from the volume or the centre of mass of a symmetric part. To check that the design follows its parameters, `check_parameters {"set": {name: value}}` tries the values and puts the design back (volume, errors, cylinder axes), or change them in one `batch` with `coalesce_parameters: true` (one rebuild), `measure`, then set them back the same way before saving.

Fix, don't rebuild: a wrong number in a feature is changed with `timeline.edit` or `parameters.change` on its input (`parameters.list {"filter":"feature"}` names them); `edit.checkpoint` and `edit.restore_checkpoint` go back exactly.

A call whose error starts `still running:` was not cancelled: don't send it again; `pending` waits for its result. Backend: headless in-process SolidCraft session.
