Eggmansmile/DIY-Auto/KiCad/DIY-Auto_schema.pdf

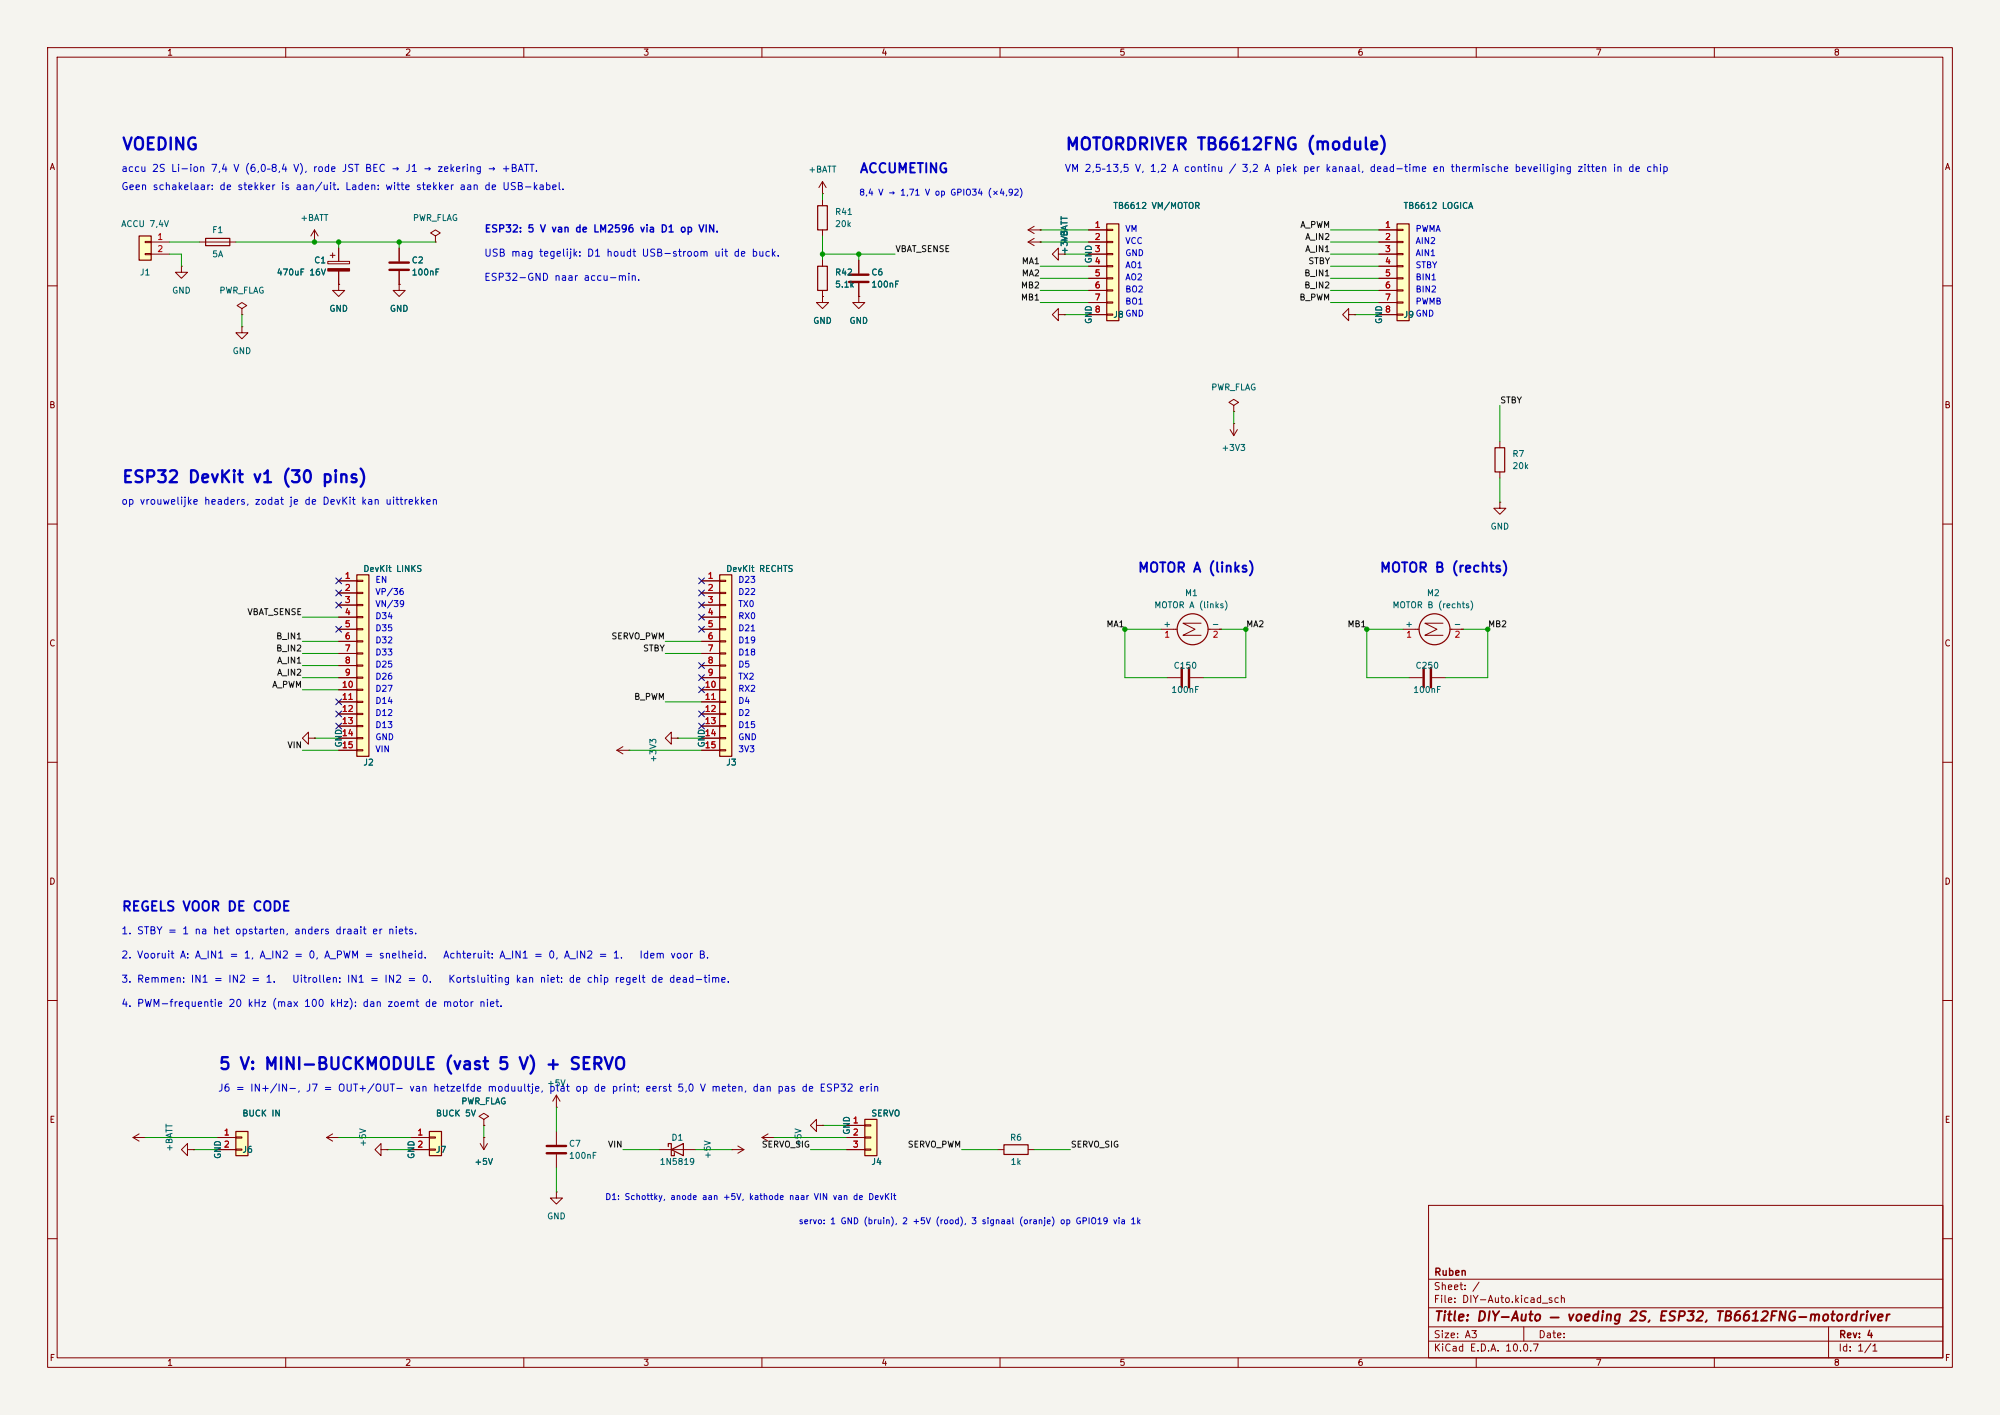
[picture p46: page 1]

accu 2S Li-ion 7,4 V (6,0–8,4 V), rode JST BEC → J1 → zekering → +BATT.

PWMA VM 2,5–13,5 V, 1,2 A continu / 3,2 A piek per kanaal, dead-time en thermische beveiliging zitten in de chip

Geen schakelaar: de stekker is aan/uit. Laden: witte stekker aan de USB-kabel.

A_IN2 REGELS VOOR DE CODE

ESP32: 5 V van de LM2596 via D1 op VIN.

USB mag tegelijk: D1 houdt USB-stroom uit de buck. GND

D21 op vrouwelijke headers, zodat je de DevKit kan uittrekken

D32 D33 1. STBY = 1 na het opstarten, anders draait er niets. D25

4. PWM-frequentie 20 kHz (max 100 kHz): dan zoemt de motor niet.

5 V: MINI-BUCKMODULE (vast 5 V) + SERVO

J6 = IN+/IN-, J7 = OUT+/OUT- van hetzelfde moduultje, plat op de print; eerst 5,0 V meten, dan pas de ESP32 erin

servo: 1 GND (bruin), 2 +5V (rood), 3 signaal (oranje) op GPIO19 via 1k D1: Schottky, anode aan +5V, kathode naar VIN van de DevKit

Sheet: /
File: DIY-Auto.kicad_sch
Title: DIY-Auto — voeding 2S, ESP32, TB6612FNG-motordriver

Size: A3 | Rev: 4 | F Date:
KiCad E.D.A. 10.0.7 | Id: 1/1
