Eggmansmile/DIY-Auto/(list of files, drawings)

Other design files:
Fritzing/DIY-Auto.fzz
