Eggmansmile/DIY-Auto/KiCad/DIY-Auto.kicad_pcb

## KiCad design KiCad/DIY-Auto.kicad_pcb (2026-11-07)

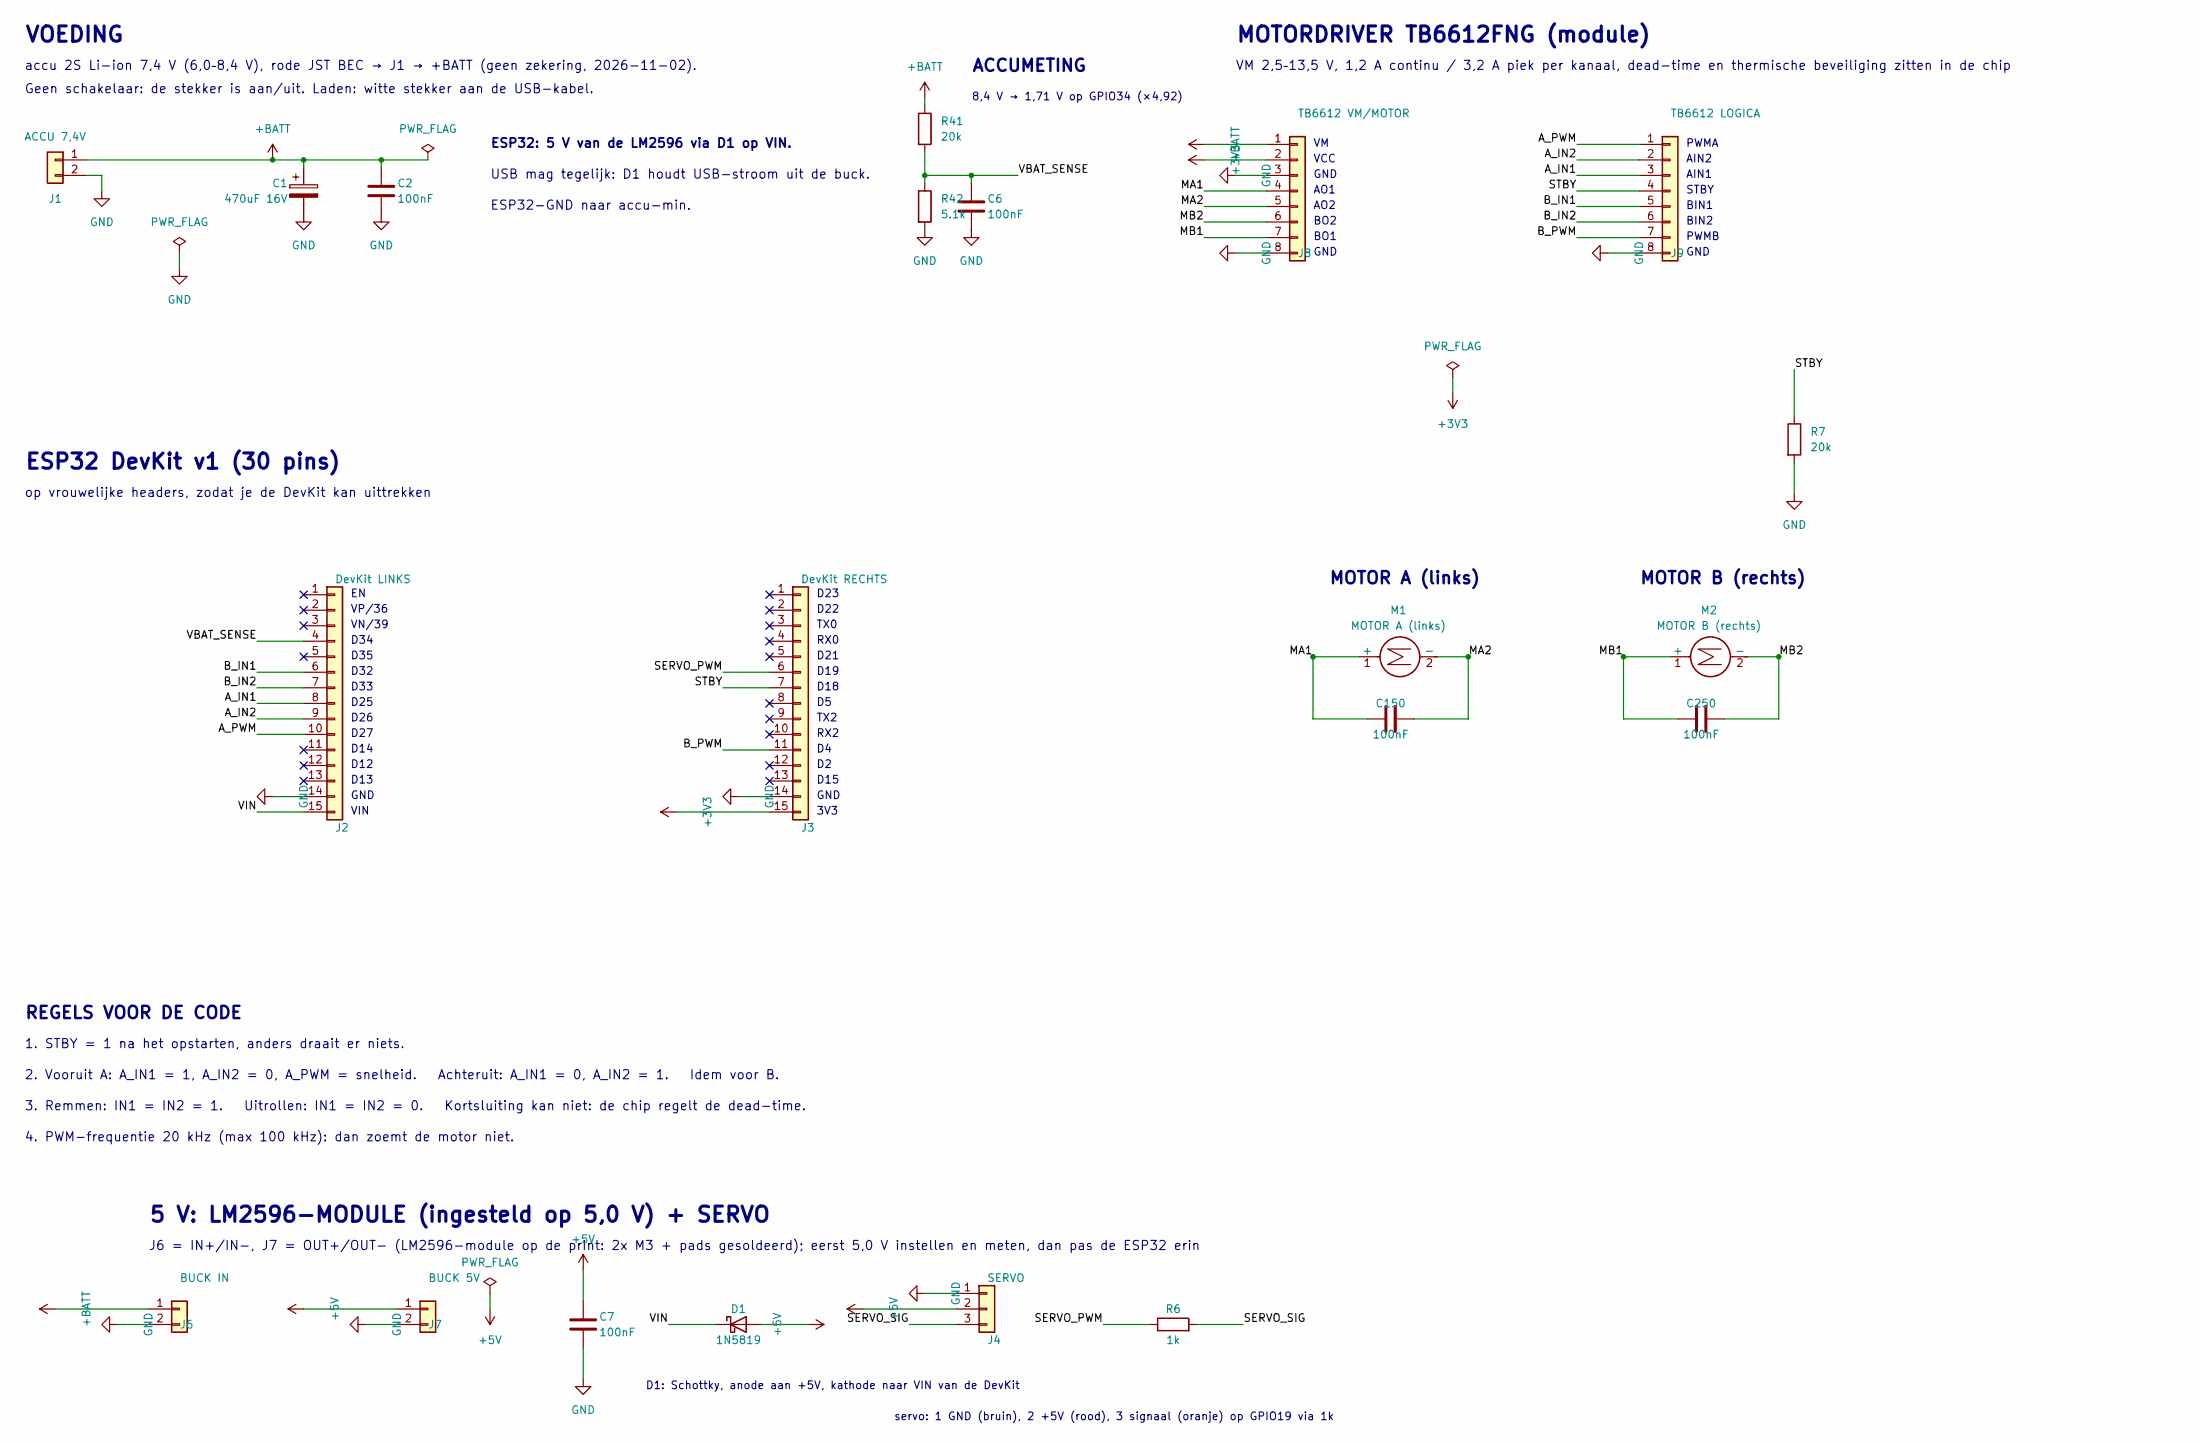
[picture p47: schematic DIY-Auto.kicad_sch, DIY-Auto — voeding 2S, ESP32, TB6612FNG-motordriver]

Parts:
C1: 470uF 16V; CP_Radial_D10.0mm_P5.00mm
C2, C6, C7, C150, C250: 100nF; C_Disc_D5.0mm_W2.5mm_P5.00mm
D1: 1N5819; D_DO-41_SOD81_P10.16mm_Horizontal
J1: ACCU 7,4V; TerminalBlock_Phoenix_MKDS-1,5-2_1x02_P5.00mm_Horizontal
J2: DevKit LINKS; PinSocket_1x15_P2.54mm_Vertical
J3: DevKit RECHTS; PinSocket_1x15_P2.54mm_Vertical
J4: SERVO; PinHeader_1x03_P2.54mm_Vertical
J6: BUCK IN; LM2596_IN
J7: BUCK 5V; LM2596_OUT
J8: TB6612 VM/MOTOR; PinSocket_1x08_P2.54mm_Vertical
J9: TB6612 LOGICA; PinSocket_1x08_P2.54mm_Vertical
M1: MOTOR A (links); TerminalBlock_Phoenix_MKDS-1,5-2_1x02_P5.00mm_Horizontal
M2: MOTOR B (rechts); TerminalBlock_Phoenix_MKDS-1,5-2_1x02_P5.00mm_Horizontal
R6: 1k; R_Axial_DIN0207_L6.3mm_D2.5mm_P10.16mm_Horizontal
R7, R41: 20k; R_Axial_DIN0207_L6.3mm_D2.5mm_P10.16mm_Horizontal
R42: 5.1k; R_Axial_DIN0207_L6.3mm_D2.5mm_P10.16mm_Horizontal

Connections:
+3V3: J3.15, J8.2
+5V: C7.1, D1.2 (A), J4.2, J7.1
+BATT: C1.1, C2.1, J1.1, J6.1, J8.1, R41.1
/A_IN1: J2.8, J9.3
/A_IN2: J2.9, J9.2
/A_PWM: J2.10, J9.1
/B_IN1: J2.6, J9.5
/B_IN2: J2.7, J9.6
/B_PWM: J3.11, J9.7
/MA1: C150.1, J8.4, M1.1 (+)
/MA2: C150.2, J8.5, M1.2 (-)
/MB1: C250.1, J8.7, M2.1 (+)
/MB2: C250.2, J8.6, M2.2 (-)
/SERVO_PWM: J3.6, R6.1
/SERVO_SIG: J4.3, R6.2
/STBY: J3.7, J9.4, R7.1
/VBAT_SENSE: C6.1, J2.4, R41.2, R42.1
/VIN: D1.1 (K), J2.15
GND: C1.2, C2.2, C6.2, C7.2, J1.2, J2.14, J3.14, J4.1, J6.2, J7.2, J8.3, J8.8, J9.8, R7.2, R42.2

Notes on the sheet:
VOEDING
accu 2S Li-ion 7,4 V (6,0–8,4 V), rode JST BEC → J1 → +BATT (geen zekering, 2026-11-02).
Geen schakelaar: de stekker is aan/uit. Laden: witte stekker aan de USB-kabel.
ESP32: 5 V van de LM2596 via D1 op VIN.
USB mag tegelijk: D1 houdt USB-stroom uit de buck.
ESP32-GND naar accu-min.
ACCUMETING
8,4 V → 1,71 V op GPIO34 (×4,92)
ESP32 DevKit v1 (30 pins)
op vrouwelijke headers, zodat je de DevKit kan uittrekken
VP/36
VN/39
D34
D35
D32
D33
D25
D26
D27
D14
D12
D13
GND
VIN
D23
D22
TX0
RX0
D21
D19
D18
TX2
RX2
D15
3V3
5 V: LM2596-MODULE (ingesteld op 5,0 V) + SERVO
J6 = IN+/IN-, J7 = OUT+/OUT- (LM2596-module op de print: 2x M3 + pads gesoldeerd); eerst 5,0 V instellen en meten, dan pas de ESP32 erin
D1: Schottky, anode aan +5V, kathode naar VIN van de DevKit
servo: 1 GND (bruin), 2 +5V (rood), 3 signaal (oranje) op GPIO19 via 1k
MOTORDRIVER TB6612FNG (module)
VM 2,5–13,5 V, 1,2 A continu / 3,2 A piek per kanaal, dead-time en thermische beveiliging zitten in de chip
VCC
AO1
AO2
BO2
BO1
PWMA
AIN2
AIN1
STBY
BIN1
BIN2
PWMB
MOTOR A (links)
MOTOR B (rechts)
REGELS VOOR DE CODE
1. STBY = 1 na het opstarten, anders draait er niets.
2. Vooruit A: A_IN1 = 1, A_IN2 = 0, A_PWM = snelheid. Achteruit: A_IN1 = 0, A_IN2 = 1. Idem voor B.
3. Remmen: IN1 = IN2 = 1. Uitrollen: IN1 = IN2 = 0. Kortsluiting kan niet: de chip regelt de dead-time.
4. PWM-frequentie 20 kHz (max 100 kHz): dan zoemt de motor niet.

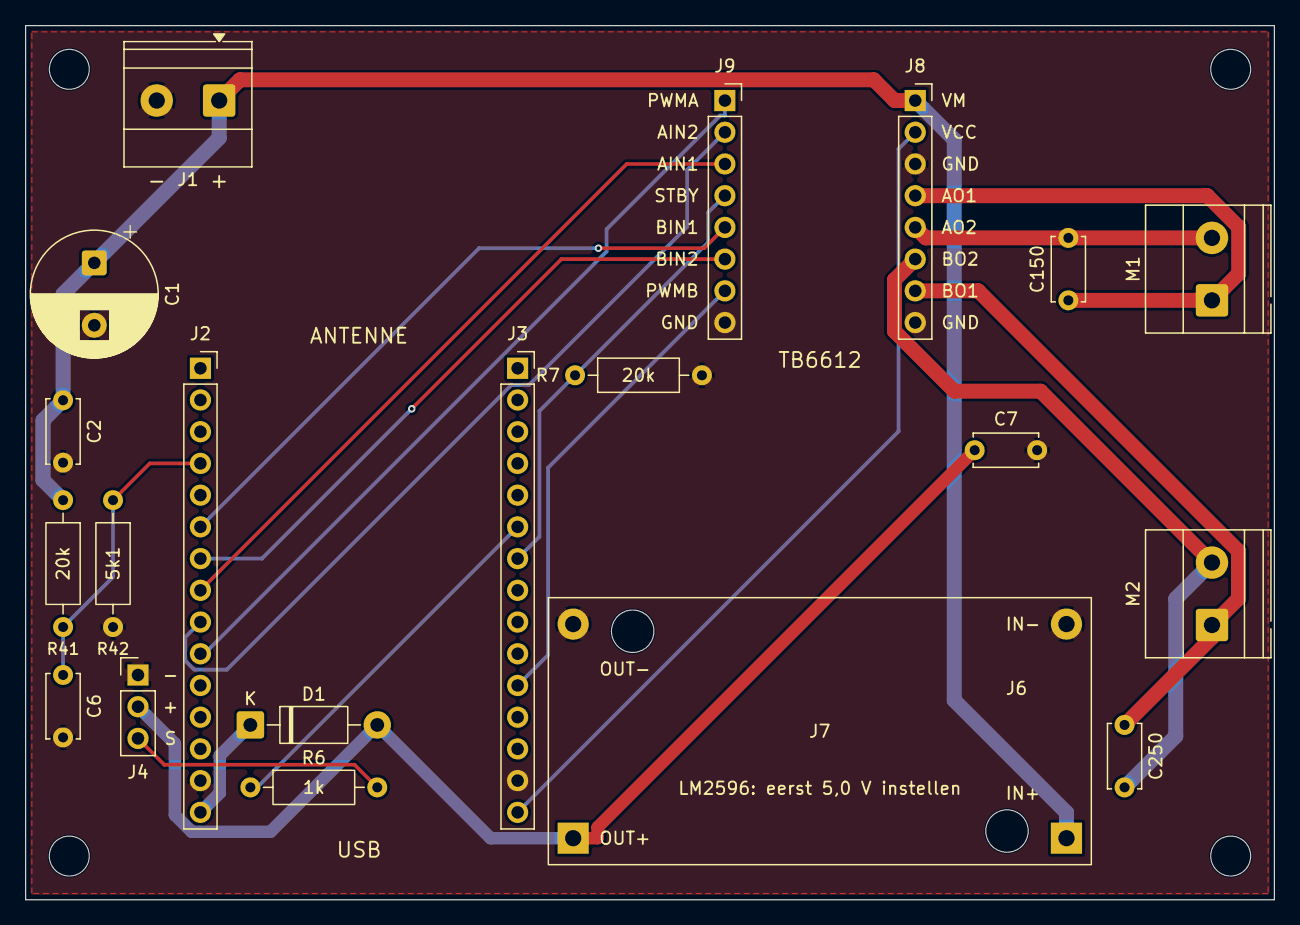
[picture p48: board DIY-Auto.kicad_pcb from above]

Board: 2 copper layers, 100.0 x 70.0 mm, 25 parts (0 on the bottom side), 19 nets.

Other parts of the board:
H1, H2, H3, H4: MountingHole_3.2mm_M3
