Eggmansmile/DIY-Auto/(commit log)

2026-11-07 V1: DIY Auto (CAD, PCB rev 8, firmware, notes)
    [DIY-Auto-B_Cu.gbl, DIY-Auto-B_Cu.gbr, DIY-Auto-B_Mask.gbr, DIY-Auto-B_Mask.gbs, DIY-Auto-B_Paste.gbr, DIY-Auto-B_Silkscreen.gbo, DIY-Auto-B_Silkscreen.gbr, DIY-Auto-Edge_Cuts.gbr]
2026-11-07 CLAUDE.md: path filter and licences
2026-11-07 README images, real LM2596 in renders, video updated for buck on PCB, drop old H-bridge files
    [DIY-Auto_hbrug.fzz]
2026-11-10 Servo: cable slot behind the rear tower, +0.2 mm servo clearance
    The SM-S2309S cable exits below the floor and had no route up to the PCB.
    Add a 3.5x6 slot between the rear servo tower and the battery stop wall,
    widen the servo fit (cutout, tower ends, tab ridges) by 0.2 mm, and add
    the cable routing step to the assembly notes.
    [check_all.py, steering.py]
2026-11-10 v9 plates: rebuilt parts with the servo cable slot, drop v8 plates
    Regenerate all part STL/STEP after the cable slot and the wider servo fit,
    add the h2d-v9 plate set (same 6 ASA parts as v8) and remove the v8 plates.
    [DIYAuto_v8_ASA_H2D.3mf, DIYAuto_v8_ASA_H2D_project.3mf, DIYAuto_v9_ASA_H2D.3mf, axle_bolt_M5x20.step, axle_bolt_M5x40.step, battery_2S.step, bearing_MR105_front.step, bearing_MR105_rear.step]
2026-11-10 Fix missing beam ends at the kingpins, servo cable V-notch, video v2
    - steering.py: the 45° tower relief cut both beam ends away (kingpins hung
    in the air since V1); the relief now skips the beam
    - check_all.py: check solid beam material round each kingpin
    - servo cable: small V-notch at the front edge of the servo cutout (shaft
    end, where the cable leaves); rear slot removed
    - servo fit +0.2 mm (cutout, tower ends, tab ridges)
    - parts, v9 plate (+ README with the Orca preset), FreeCAD assembly rebuilt
    - assembly video: front end split into cable / servo / knuckle on beam /
    kingpin through lugs + beam (see-through knuckle) / wheels / tie rods
    - assembly notes: cable step
    Co-Authored-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
    [DIY-Auto.FCStd, DIYAuto_v9_ASA_H2D.3mf, axle_bolt_M5x20.step, axle_bolt_M5x40.step, battery_2S.step, bearing_MR105_front.step, bearing_MR105_rear.step, body.step]
2026-11-12 CAD: SolidCraft master, build123d archived
    - CAD/DIY-Auto.sc master assembly (5 folder components, joints for wheels and kingpins) with linked part designs in CAD/solidcraft/
    - Scripts/cad: sc_build.py, export_sc.py, sc_gen/; export_sc.py writes CAD/parts STEP/STL, manifest and BOM
    - check_all.py and gen_drawing.py read the STEPs; build123d modules moved to Scripts/cad/archive_build123d/
    - Drop DIY-Auto.FCStd; remotion render now deletes the Blender frames
    [DIY-Auto.FCStd, DIYAuto_v9_ASA_H2D.3mf, body.step, body.stl, clamp_L.step, clamp_L.stl, clamp_R.step, clamp_R.stl]
2026-11-12 Mechanisch: beweging in SolidCraft beschreven zoals het is
